Stefmci/ELEK_Inv_Pen/README.md

# 🔩 **PCB-Entwicklung – Chaos™**  

## 📁 Inhalt  

Hier findest du:  
- 🛠 Schaltpläne, die irgendwann funktionieren könnten  
- 📜 Geroutete Leiterbahnen mit fragwürdiger Eleganz  
- 🔥 Fehlerlisten, die mit jedem Testlauf länger werden  
- ⚡️ Magic Smoke™ – wenn wieder etwas *nicht ganz* geklappt hat  

## ⚠️ Warnung  

Dieses Repo enthält:  
- **Mysteröse Netzlisten**, die sich von selbst ändern  
- **Bauteile, die eigentlich kompatibel sein sollten** (aber nicht sind)  
- **Geroutete Antennen**, die sicher irgendwie gut sind  
- **Design-Rule-Warnings**, die ich absichtlich ignoriere  

💡 **Benutzung auf eigene Gefahr. Keine Garantie auf Funktion oder dass dein STM32 nach dem ersten Test noch lebt.**  

## 🧠 Motivation  

- 10% Ingenieurskunst  
- 30% Trial & Error  
- 60% „Warum drehen sich die Motoren nicht?“  

## 🚀 Roadmap  

- [ ] PCB entwerfen **ohne Kurzschlussfestival**  
- [ ] STM32 mittels **in vielleicht in Zukunft erstellter Firmware** ansteuern
- [ ] Mindestens **eine Platine löten**, ohne den Rauchmelder auszulösen   

## 📜 Lizenz  

Solange du meinen Schaltplan nicht benutzt, um einen Lötwettbewerb zu gewinnen:  
**Mach, was du willst! 😎**
