Stefmci/ELEK_Inv_Pen/Eckstein_Goetz_Hoertnagl.pdf

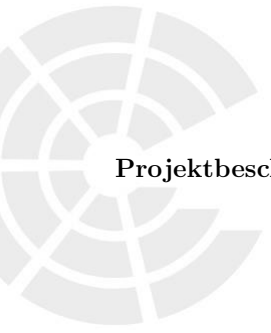
[picture p1: figure]

# Projektbeschreibung inverses Pendel

Bachelor: Mechatronik

### 4. Semester

Lehrveranstaltungsleiter: Matthias Gfall

Gruppe: BA-MECH-23

Verfasser: Stefan Hörtnagl, Lennart Götz, Maximilian Eckstein

### 30. Juni 2025

# Einleitung

Im Rahmen der Lehrveranstaltung ”

Elektronische Produktentwicklung 1” wurde mit der hardwareseitigen Entwicklung eines mobilen inversen Pendels begonnen. Das Ziel des Projekts besteht darin, einen zweirädrigen Roboter mit Dualantrieb zu entwickeln und zu bauen, der einen Pendelkörper in instabiler Gleichgewichtslage balanciert. [1]

Zentrales Thema dieses Semester war die Hardwarekonzeptionierung und -entwicklung. Ein Mikrocontroller erfasst die Sensordaten, verarbeitet sie und steuert entsprechend die Motoren, um das System zu stabilisieren.[1]

Basierend auf einer Literaturrecherche zur Regelung inverser Pendel wurde ein Grobkonzept erstellt, das die Auswahl geeigneter Komponenten (Sensoren, Aktoren und Mikrocontroller) sowie die Konstruktion, das Schaltungsdesign und die PCB-Entwicklung umfasst. Aufgrund der Komplexität des Themas sind mindestens zwei Hardware-Iterationen vorgesehen. Im ersten Teil der Lehrveranstaltung wurde zunächst die digitale Entwicklung umgesetzt.[1]

Nach Abschluss kann der entwickelte Aufbau als Demonstrator oder als Plattform fur Laborversuche ¨ im Bereich der Regelungstechnik eingesetzt werden.[1]

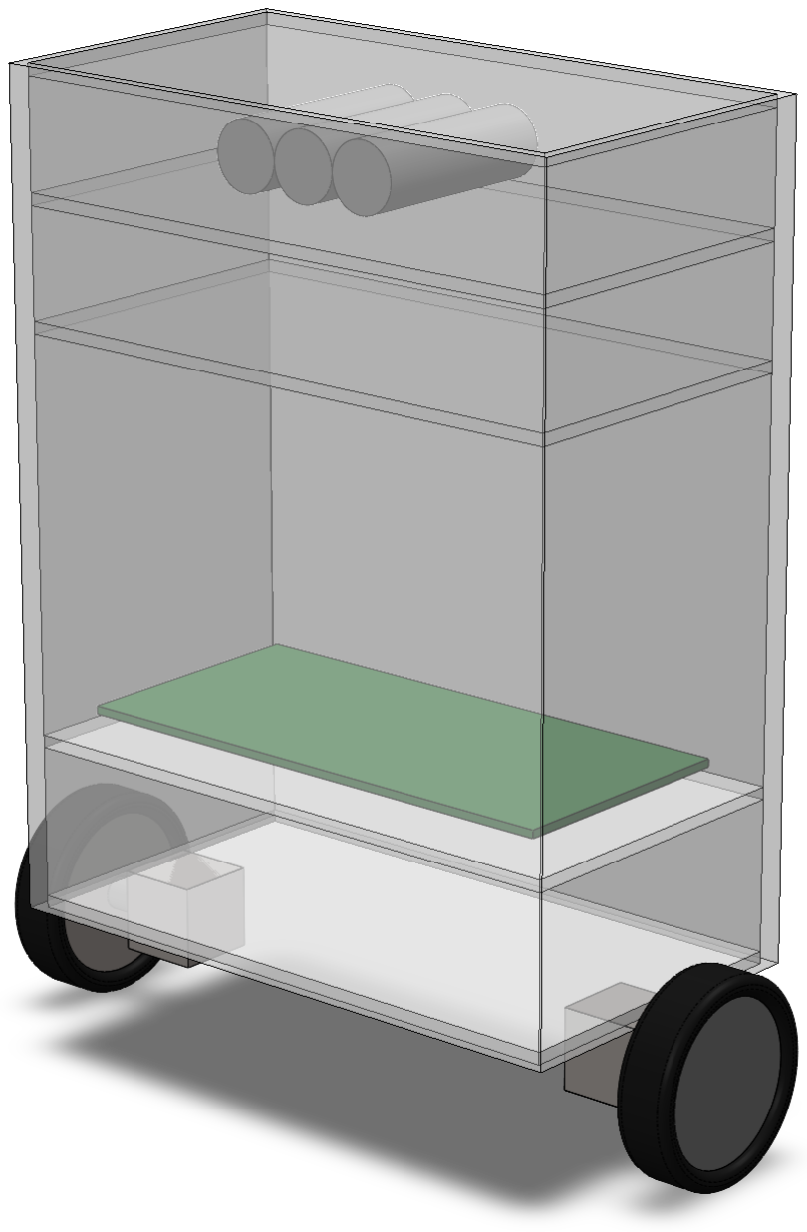
[picture p2: figure]

Abbildung 0.1: Entwurf inverses Pendel

II

# Inhaltsverzeichnis

1 Projektzusammenfassung | 1
2 Konzeptionierung | 1
3 Schaltungsentwicklung | 3
4 PCB Design | 20
4.7 Leiterplattendesign fur ein Standalone ESP8266EX-Modul | ¨ | 23

III

5 Mechanischer Aufbau | 26
6 Kostenkalkulation | 28
7 Pinbelegung und Funktionszuordnung | 29
Abbildungsverzeichnis | V
Tabellenverzeichnis | VI
Literaturverzeichnis | VII

IV

# 1 Projektzusammenfassung

Gegenstand des Projekts ist der Bau eines Fahrgestells fur den Einsatz in der Lehre. Das Gestell soll ¨ als inverses Pendel ausgefuhrt werden und sich – nach Implementierung eines geeigneten Regelalgo- ¨ rithmus – selbstständig in der oberen Ruhelage stabilisieren. Daraus ergeben sich die in Kapitel 2 beschriebenen Anforderungen. [1]

Obwohl das System in weiten Teilen digital konzipiert und in Form von Schaltplänen, PCB-Layouts und 3D-Modellen ausgearbeitet wurde, konnte aufgrund der hohen Komplexität und des begrenzten zeitlichen Rahmens bislang keine physische Umsetzung erfolgen. Die Realisierung des Prototyps ist
jedoch fur eine sp ¨ | ätere Projektphase vorgesehen.[1]

# 2 Konzeptionierung

### 2.1 ENERGIEVERSORGUNG

Um einen sicheren Betrieb, schnelle Ladezeiten und den geforderten einfachen Akkuwechsel zu ermöglichen, kommt ein Lithium-Ionen Akku von Makita zum Einsatz. Dieser bietet eine hohe Energiedichte und beinhaltet bereits ein Battery-Management System welches Tiefenentladungen verhindert.
Außerdem sind im Gestell zwei verschiedene Steckplätze fur den Akku vorgesehen. Dies erm ¨ | öglicht
eine Variation des Schwerpunkts des Gesamtsystems.

Da die Spannung des Akkus unter Belastung signifikant absinken kann, wird ein DC-DC Wandler zur Entkopplung verwendet. Dadurch bleibt die Spannung am Motortreiber auch unter Last stabil. Die Regelung der Motorleistung wird dadurch ebenfalls vereinfacht.

### 2.2 ANTRIEB

Motorauslegung:
Fur die Motorauswahl wurde zun ¨ | ächst ein maximaler Neigungswinkel definiert, bei dem das Pendel
noch stabilisiert werden soll. Mithilfe dieses Neigungswinkels wurde ein maximales Kippmoment berechnet, das als Auslegungskriterium fur das erforderliche Motordrehmoment herangezogen wurde. ¨

Zur Berechnung des Kippmoments in MATLAB wurde der mechanische Aufbau des Pendels einschließlich seiner Dimensionen definiert. Sämtliche Bauteile wurden virtuell innerhalb des Systems positioniert. Mithilfe des Schwerpunktsatzes konnte der Gesamtschwerpunkt des Pendels approximiert werden. In Kombination mit dem vorgegebenen Neigungswinkel wurde daraus das maximale Kippmoment inklusive Sicherheitsreserve ermittelt.

Von Seiten des MCI wurde empfohlen, einen Gleichstrommotor mit Getriebe zu verwenden. Nachdem das erforderliche Drehmoment sowie die Betriebsspannung (12V) festgelegt worden waren, konnte ein geeigneter Motor ausgewählt werden. Neben dem Drehmoment war dabei auch eine ausreichend hohe Drehzahl entscheidend, um schnelle Regelbewegungen zu ermöglichen und das Pendel zuverlässig in der oberen Ruhelage auszuregeln.

Motor Treiber:
Um das Drehmoment der gewählten Motoren uber den STM32 regeln zu k ¨ | önnen, wird eine geeignete
Leistungselektronik benötigt. Zum Einsatz kommt eine H-Brucke, die ein PWM-Signal zur Ansteue- ¨ rung der Motoren erzeugt. Durch Variation des Duty Cycles wird der Effektivwert der Motorspannung angepasst. Infolgedessen stellt sich ein mittlerer Motorstrom ein, der das resultierende Drehmoment bestimmt.

Es bestehen folgende Anforderungen an die H-Brucke: ¨ Betriebsspannung: 12V
maximale Strombelastung: 7A
optional: Unterstutzung von 2 Motoren ¨
optional: Unterstutzung von 3.3V Signalen des STM32 ¨

Anhand dieser Merkmale, wurde ein Dual-Channel Motor Treiber mit folgenden technischen Daten ausgewählt:

Betriebsspannung | 6.5V - 37V
Imax | 12A
Ipeak | 70A
Steuerspannung | 3V - 5V

Tabelle 2.1: Technische Daten

### 2.3 KOMMUNIKATIONSSCHNITTSTELLEN

Eine Kernanforderung an das System ist die Unterstutzung der MATLAB-Codegenerierung. Aus Si- ¨ mulink soll C-Code generiert werden, der anschließend uber eine USB-Schnittstelle auf den Controller ¨ ubertragen wird. ¨
Zusätzlich sollen Telemetriedaten während des Betriebs drahtlos ubertragen werden k ¨ | önnen. Dazu
wurde ein ESP8266 Chip integriert, der Daten vom Controller empfängt und uber WiFi versenden ¨ kann. Der ESP8266 soll - ebenso wie der Mikrocontroller - uber USB (via UART) programmierbar ¨ sein.
Da der ESP8266 nur uber eine einzige UART-Schnittstelle verf ¨ | ugt, wurde ein dualer Signal-Multiplexer ¨
eingesetzt, um sowohl die Programmierung als auch die Kommunikation mit dem STM32 zu ermöglichen.

Aus diesen Anforderungen entwickelten wir folgende Topologie fur die UART-Kommunikation: ¨

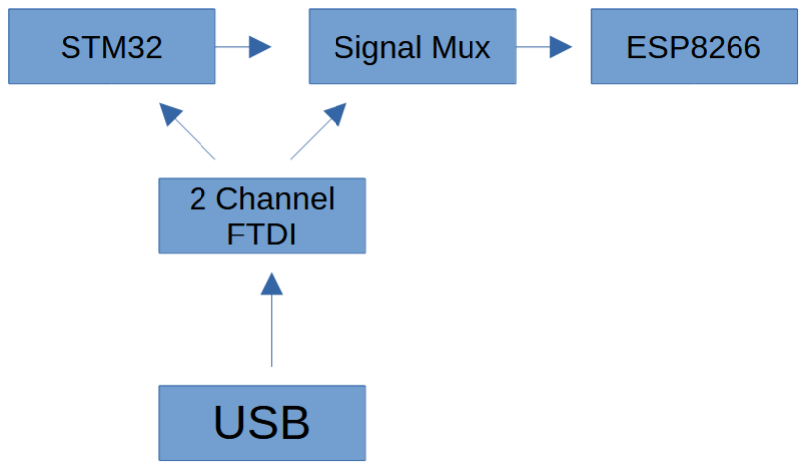
[picture p3: figure]

Abbildung 2.1: UART Topologie

### 2.4 SENSORIK

Um den Pendelkörper in der oberen Ruhelage ausregeln zu können, muss dessen Neigung erfasst werden. Ergänzend liefert die Messung der Beschleunigung wertvolle Informationen uber die System- ¨ dynamik.
Zur Erfassung von Neigung und Beschleunigung wurde der Inertialsensor LSM6DSOX ausgewählt. Dieser kombiniert einen 3-Achsen-Beschleunigungssensor mit einem 3-Achsen-Gyroskop und ermöglicht so eine präzise Erfassung der Bewegungs- und Lageinformationen bei gleichzeitig geringem Energieverbrauch.

# 3 Schaltungsentwicklung

### 3.1 STM32 UND LAGESENSOR

Um die Regelung des inversen Pendels zu implementieren, wird ein Mikrokontroller verwendet. Da der Steuerungs-Code automatisch aus MATLAB generiert werden soll, wurde hier auf entsprechende Kompatibilität geachtet. Um ausreichend Rechenleistung fur zuk ¨ unftige Erweiterungen (z.B. LI- ¨ DAR) bereitzustellen, fiel die Wahl auf einen STM32H7A3. Zur Reduzierung der Komplexität wurde ein Gehäuse mit 64 Pins verwendet, um ein möglichst minimalistisches Leiterplattenlayout zu ermöglichen.

Um den stabilen Betrieb des STM32 zu ermöglichen, haben wir uns am Design-Guide von STMicroelectronics speziell fur diese Chipserie orientiert. An geeigneter Stelle wurden Keramikkondensatoren ¨ platziert um die Spannungsversorgung zu stabilisieren. Außerdem wird einen externer Quarz mit 24Mhz verwendet, da das resultierende Clocksignal damit frequenzstabiler ist.

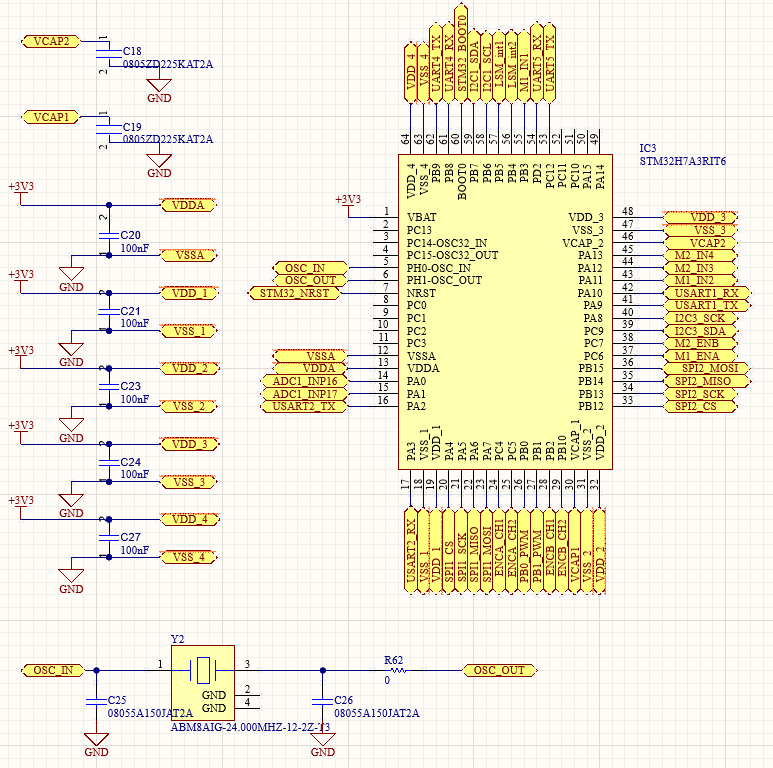
[picture p4: figure]

Abbildung 3.1: STM32 mit Quarz und Kondensatoren

Zur Erfassung der Neigung des Pendels sowie gegebenenfalls der Beschleunigung wurde ein geeigneter Sensor integriert. Die ursprunglich in Betracht gezogene und weit verbreitete MPU9250 wurde ¨ verworfen, da der Hersteller die Produktion eingestellt hat. Stattdessen kommt ein LSM6DSOX von STMicroelectronics zum Einsatz. Dieser Chip umfasst ein 3-Achsen-Gyroskop sowie Beschleunigungs-
messung in 3 Achsen. Die Sensordaten werden uber eine SPI Verbindung an den STM32 ¨ | ubermittelt. ¨
Da die Schnittstelle bidirectional ist, kann der Sensor auch uber den STM32 konfiguriert werden. ¨ Beim Schaltungsdesign wurde sich erneut an der Dokumentation von STMicroelectronics orientiert. Zur Glättung der Versorgungsspannung wurden Keramikkondensatoren in unmittelbarer Nähe zum Sensor platziert.

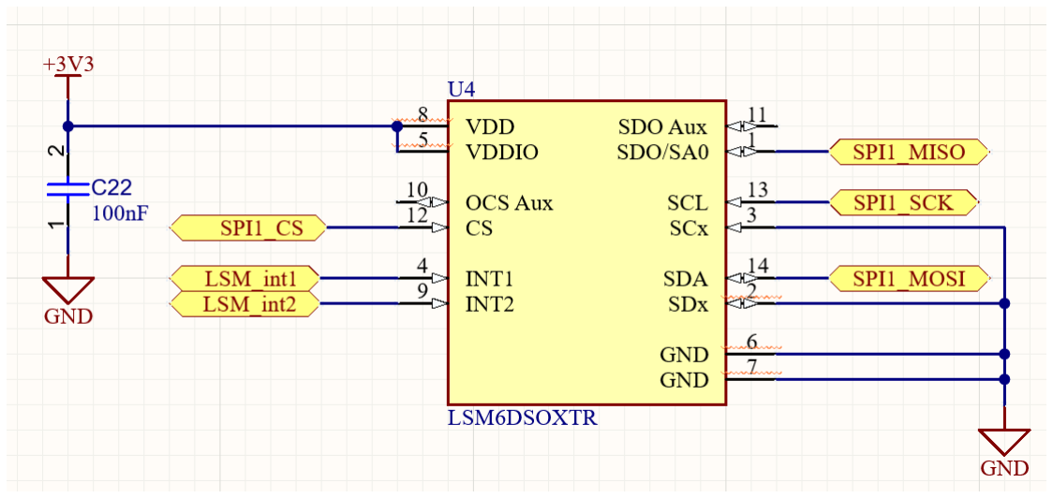
[picture p5: figure]

Abbildung 3.2: LSM6DSOX

### 3.2 UART KOMMUNIKATION

Basierend auf unserer UART-Topologie wurde die Umsetzung der UART-Kommunikation in drei Teile gegliedert: FTDI-Chip (USB-UART), UART-Signalumschaltung und Bootloader Aktivierung

FTDI-Chip:

Mithilfe des FTDI-Chips können sowohl der STM32 als auch der ESP8266 programmiert werden. Der
Chip verfugt ¨ | uber zwei unabh ¨ | ängige UART-Kanäle, die vom Computer jeweils als separate virtuelle
COM-Ports erkannt und genutzt werden können. Dadurch ist es gezielt möglich, den gewunschten ¨
Controller fur die Programmierung auszuw ¨ | | ählen.
Prinzipiell fungiert der FTDI-Chip als Signalumsetzer: Er wandelt das eingangsseitige USB-Signal vom PC in ein TTL/UART-Signal um, das von den Controllern verarbeitet werden kann.
Bei der Ausarbeitung der Beschaltung des FTDI-Chips wurde neben dem Design Guide des Herstellers auch ein bestehendes Breakout-Modul von FTDI herangezogen, das auf demselben Chip basiert. Der EEPROM-Speicher ist nicht essenziell fur den Betrieb, kann jedoch zur Ablage hilfreicher Infor- ¨ mationen genutzt werden – beispielsweise eines benutzerdefinierten Gerätenamens oder der Konfiguration des COM-Ports. Dies erleichtert die Handhabung und Integration des Projekts insbesondere bei mehrfacher Verwendung an verschiedenen Computern.
Der FTDI ist so beschaltet, dass er nur aktiv wird, sobald ein Gerät am USB-C-Port angeschlossen ist.
Daruber hinaus verf ¨ | ugt der FTDI ¨ | uber einen externen Schwingkreis, um ein stabiles Taktsignal be- ¨
reitzustellen, das fur eine zuverl ¨ | ässige USB-Kommunikation gemäß Spezifikation erforderlich ist.
Kondensatoren und Ferritperlen dienen der Entkopplung sowie der Filterung hochfrequenter Störungen und verbessern dadurch die Signalqualität sowie die EMV-Eigenschaften der Schaltung.
Außerdem wurden vier Status-LEDs zur Anzeige der RX- und TX-Aktivität von Kanal 1 und 2 implementiert.

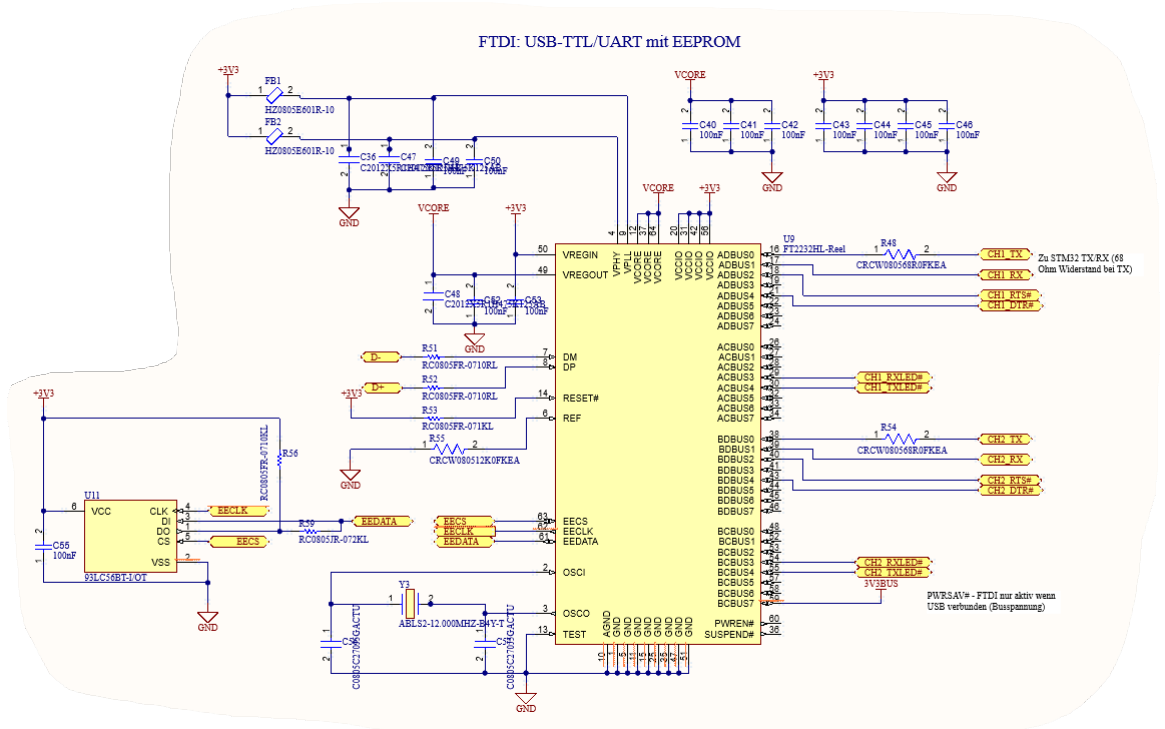
[picture p6: figure]

Abbildung 3.3: FTDI-Chip mit Peripherie

UART-Signalumschaltung:

Zur flexiblen Umschaltung der UART-Verbindung des ESP8266 zwischen STM32 und FTDI wurde ein analoger Multiplexer (TS5A23157) implementiert. Dieser ermöglicht, abhängig von den Steuerleitungen IN1 und IN2, die gezielte Verbindung der TX- und RX-Leitungen entweder zum Mikrocontroller (STM32) oder zum USB-UART-Konverter (FTDI CH2). Die Steuerung kann automatisch uber die ¨ invertierte RTS-Leitung des FTDI erfolgen oder manuell per Schalter.
Schalter 1 legt fest, ob die Umschaltung automatisch (uber die RTS-Leitung des FTDI) oder manu- ¨ ell erfolgt. Schalter 2 bestimmt – im manuellen Modus – welcher UART-Kanal mit dem ESP8266 verbunden wird.
Da der ESP8266 im Normalfall nur selten programmiert werden muss, ist die Standardverbindung uber die NC-Kontakte (Normally Closed) mit dem STM32 vorgesehen. ¨
Da jeweils einer der beiden UART-Pfade (STM32–ESP oder FTDI–ESP) inaktiv ist, wurden beide RX-Leitungen mit Pull-Up-Widerständen auf High gezogen, um unerwunschtes Floating zu vermei- ¨ den. Zusätzlich sind die UART-Leitungen zum ESP8266 mit 68-Ohm-Widerständen abgesichert, um Pegelkonflikte bei gleichzeitigem Anschluss zu vermeiden.
Fur den Fall, dass die Programmierung des ESP8266 ¨ | uber die eigens entwickelte USB-UART- ¨
Schaltung nicht funktioniert, ermöglichen Jumper-Verbindungen den Anschluss eines externen Programmieradapters.

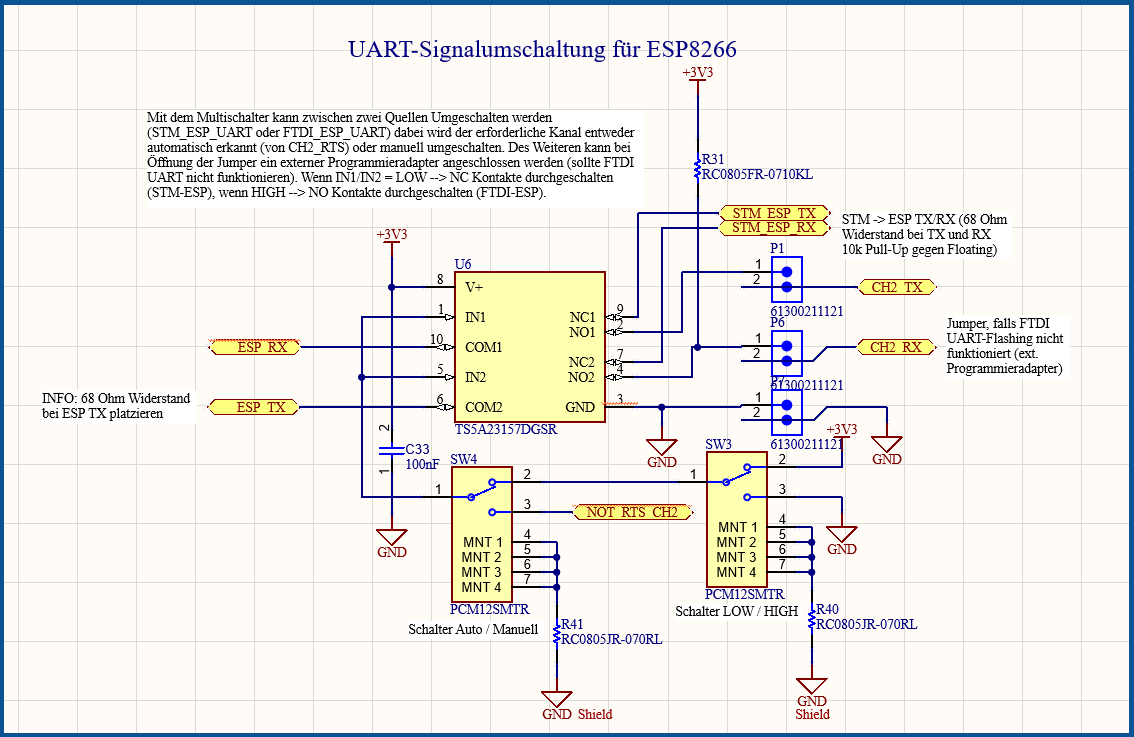
[picture p7: figure]

Abbildung 3.4: UART-Signalumschaltung

Bootloader Aktivierung:

Zur Aktivierung des Bootloaders fur STM32 und ESP8266 wurde eine Schaltung entwickelt, die ¨
sowohl automatisch uber die RTS- und DTR-Leitungen des FTDI-Chips als auch manuell ¨ | uber Taster ¨
ausgelöst werden kann. Die Signale RTS und DTR sind als active-LOW ausgefuhrt und werden ¨ | uber ¨
einen Inverterbaustein (SN74LVC14AD) sowie nachgeschaltete Open-Drain-MOSFETs entkoppelt,
um Kurzschlusse beim gleichzeitigen manuellen Bet ¨ | ätigen der Taster zu vermeiden und die FTDI-
Ausgänge zu schutzen. ¨

Da die Transistorschaltungen invertierend wirken, wird durch die zusätzliche Invertierung im IC das ursprungliche logische Verhalten wiederhergestellt. Die Umschaltung erfolgt entweder automatisch ¨
uber Softwaresteuerung durch den FTDI oder alternativ durch manuelle Bet ¨ | ätigung der vier Taster.

Fur den STM32 wird der Bootloader aktiviert, indem BOOT0 auf High und anschließend der Reset- ¨ Pin (NRST) kurzzeitig auf Low gezogen wird. Beim ESP8266 erfolgt die Aktivierung durch ein kurzes Herunterziehen des EN-Pins (Reset) bei gleichzeitigem Low-Pegel auf GPIO0. Beide Controller star-
ten so im Flashmodus und können uber die jeweilige UART-Schnittstelle programmiert werden. ¨ | Uber ¨
Jumper lassen sich die FTDI-Signale gezielt trennen, um beispielsweise einen externen Programmieradapter zu verwenden oder die automatische Umschaltung zu deaktivieren.

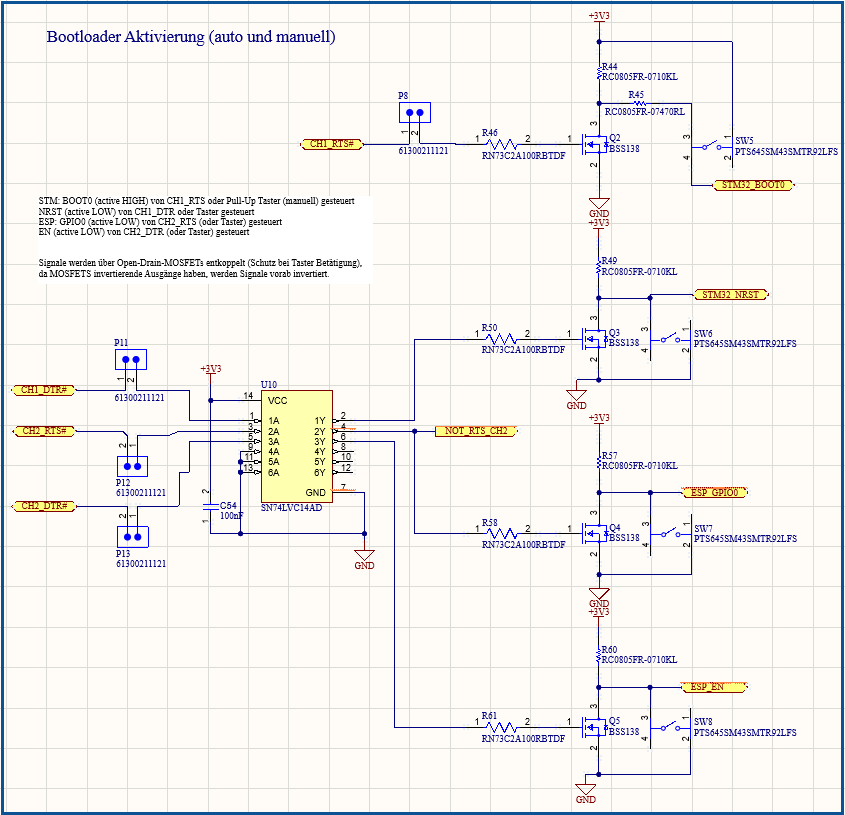
[picture p8: figure]

Abbildung 3.5: Bootloader-Schaltung

### 3.3 WIFI-SCHNITTSTELLE

Fur die drahtlose Kommunikation des Mikrocontrollers wurde der ESP8266EX[2] WiFi-Chip gew ¨ | ählt.
Er erfullt alle Projektanforderungen und besitzt eine kompakte Bauweise. Aufgrund seiner weiten ¨ Verbreitung in vielen Anwendungen ist er eine solide Basis. Der ESP8266EX bietet dabei eine Vielzahl von Funktionen:
- IEEE 802.11 b/g/n-Standard
- 32-Bit RISC-Prozessor mit bis zu 160 MHz Taktfrequenz
- diverse digitale Schnittstellen wie GPIO, SPI, I²C, UART und PWM.

Er kann im Deep-Sleep-Modus mit 20 µA im Ruhemodus gehalten werden und eignet sich dadurch besonders fur batteriebetriebene und energieeffiziente IoT-Anwendungen. ¨

Ein entscheidender Vorteil ist die Unterstutzung durch eine große Community sowie die umfangreiche ¨ Dokumentation und Softwareentwicklungsumgebung (SDK), die eine schnelle und flexible Softwareentwicklung ermöglicht. Die WLAN-Kommunikation wird hauptsächlich dazu verwendet, Echtzeitdaten der Sensoren und des Systemzustands zu senden und auf einem entsprechenden Webserver Interface wiederzugeben. Aufgrund der selbst designten PCB-Antenne wurde eine vollumfängliche Backup-Lösung vorgesehen.

### 3.3.1 Allgemeine Spezifikationen

- Prozessor: Tensilica L106, 32-bit RISC, bis 160 MHz
- Speicher: Externe SPI-Flash bis 16 MB, < 50 kB SRAM nutzbar
- Wi-Fi: 802.11 b/g/n (2.4 GHz)
- Datenrate: Bis 72.2 Mbps (802.11n)
- Schnittstellen: GPIO, UART, SPI, I2C, I2S, PWM, ADC , IR
- Betriebsspannung: 2.5 V – 3.6 V
- Stromverbrauch:

– Aktiv: ca. 80 mA
– Light-Sleep: 0.9 mA

– Deep-Sleep: 20 µA

Die herstellerspezifischen Hardware-Design-Rules wurden bei der Entwicklung des Schaltplans und des PCB-Designs berucksichtigt und eingehalten. ¨

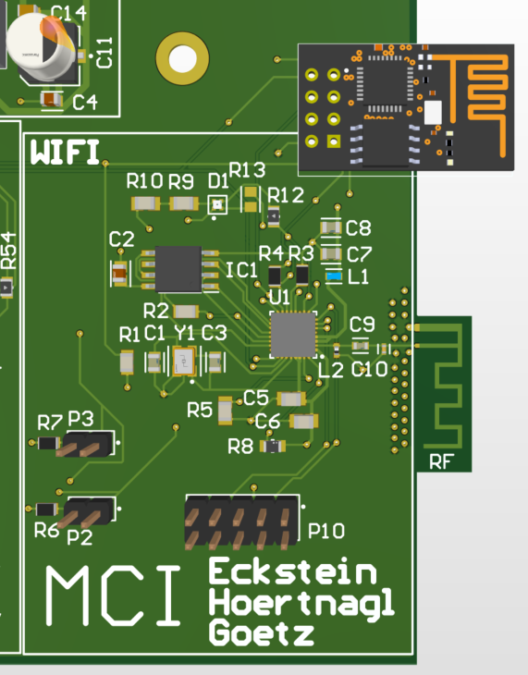
[picture p9: figure]

Abbildung 3.6: PCB Abschnitt WiFi

### 3.4 SCHALTUNGSDETAILS DES WIFI-MODULS (ESP8266)

Die Peripherie wurde hierbei in die folgenden Sektionen am Schaltplan unterteilt:

- Spannungsversorgung
- Antenne und Stromversorung Antenne
- Flash
- Oszillator
- Backup Modul
- Kleinteile

### 3.4.1 Stromversorgung

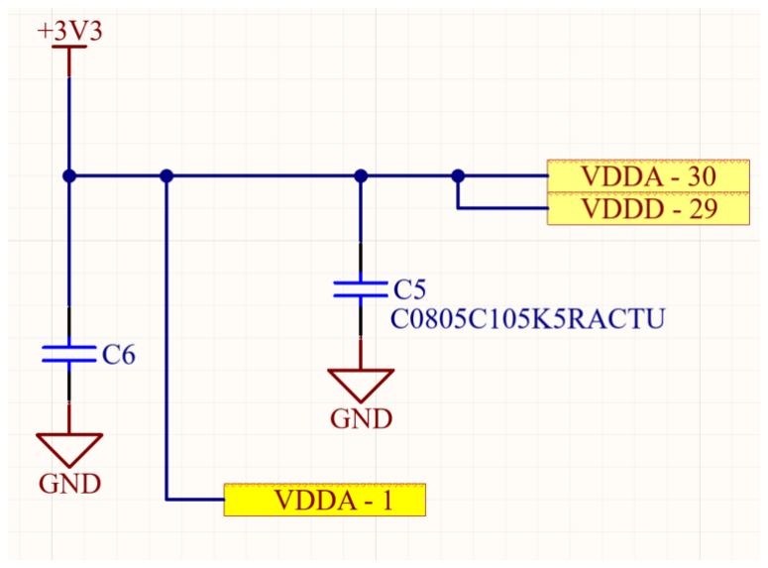
[picture p10: figure]

Abbildung 3.7: Stromversorgung ESP8266

Die Stromversorgung wurde gemäß den Design-Richtlinien[3] umgesetzt. Dazu gehören zwei 1µF-Kondensatoren, die zur Filterung hochfrequenter Störungen beitragen. Die Versorgung uber VDDA30, ¨ 29 und 1 dient der Spannungsbereitstellung fur die analogen Komponenten des ESP, die besonders ¨
empfindlich gegenuber Spannungsschwankungen sind. Daruch wird eine st ¨ | örungsfreie Verwendung
garantiert, ohne dass das Risiko von Paketverlusten oder unerwarteten Resets besteht.

### 3.4.2 Stromversorgung Antenne

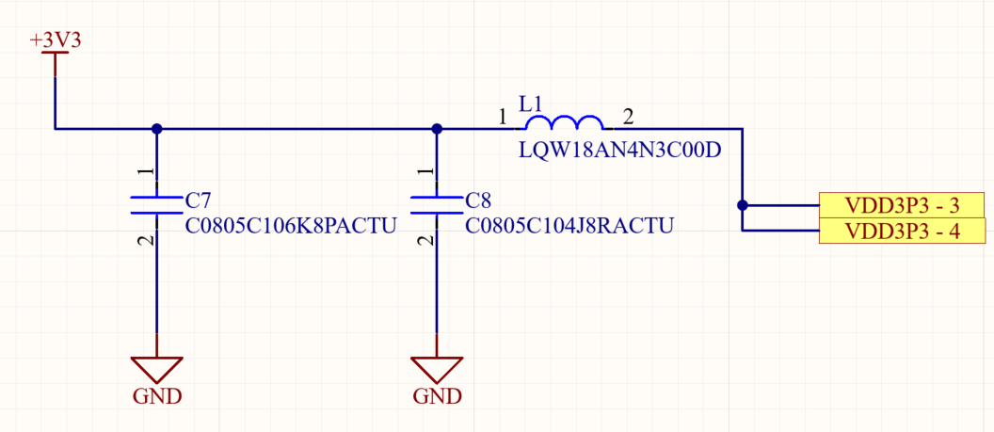
[picture p11: figure]

Abbildung 3.8: Stromversorgung Antenne

Diese Schaltung ist mit dem internen Power-Amplifier und dem Low-Noise-Amplifier verbunden und
sorgt fur die Versorgung des Antennenbereichs des Chips. Dabei fungiert der ¨ | 10µF Kondensator (C7)
als Energiespeicher, da während des Sendens ein hoher Stromverbrauch entstehen kann. Der Kondensator C8 dient zur Filterung von hochfrequenten Ruckkopplungen. Die Schaltung wurde nahe den ver- ¨ wendeten Pins im PCB-Layout vorgesehen. Dadurch werden typische Probleme wie Ruckkopplungen, ¨ Rauschen im RF-Signal oder Störungen im Betrieb vermieden.

### 3.4.3 Antenne

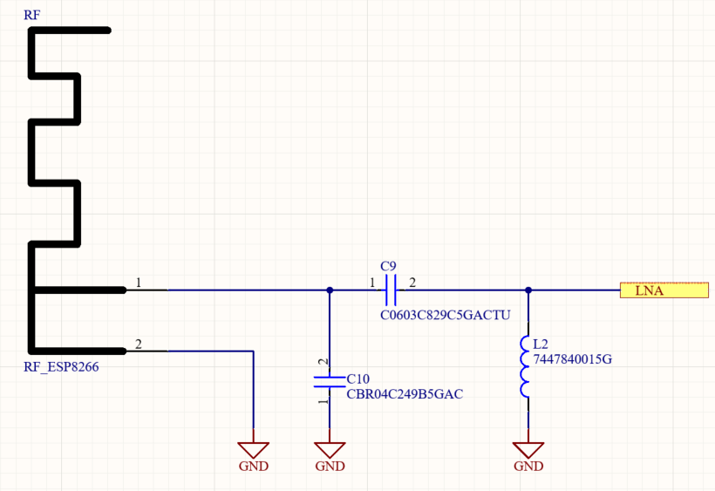
[picture p12: figure]

Abbildung 3.9: Antenne

Der RF-Ausgang des ESP8266EX hat eine charakteristische Impedanz von 39 + j6 Ω. Um eine ver-
lustarme Leistungsubertragung zur Antenne sicherzustellen, ist eine Anpassung an ¨ | 50 Ω notwendig.

Zur Impedanzanpassung des RF-Ausgangs an die 50 Ω Antenne wurde ein π-Matching-Netzwerk ausgelegt. Ziel war es, die komplexe Ausgangsimpedanz des LNA-Pins (Zs = 39 + j6 Ω) auf die Antennenimpedanz von ZL = 50 Ω abzustimmen. Als Betriebsfrequenz wurde 2.45 GHz gewählt (Mittenfrequenz im 2.4 GHz-WLAN-Band).

Fur das Matching wurde folgende Bauteilkombination verwendet: ¨

- C9 = 8,2 pF
- L2 = 1,5 nH
- C10 = 2,4 pF

Die Impedanzanpassung erfolgte mithilfe eines Matching-Rechners. Als Antenne wurde eine direkt im PCB integrierte Variante umgesetzt, die uber definierte Leiterbahnstrukturen realisiert ist. Die ¨ Antennenfläche wurde gemäß den offiziellen Hardware Design Guidelines von Espressif konsequent von metallisierten Flächen und Signalleitungen freigehalten und durch GND-Vias abgeschirmt [3]. Dadurch wird eine hohe Sendeleistung sowie eine gute Empfangsempfindlichkeit im 2.4 GHz-Band sichergestellt.

### 3.4.4 Flash

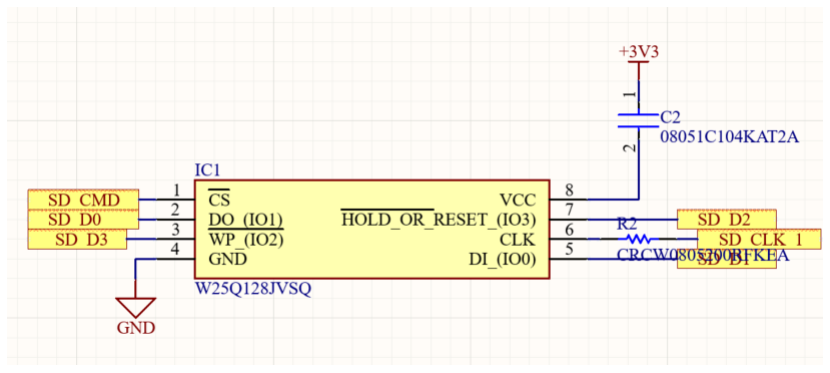
[picture p13: figure]

Abbildung 3.10: Flash Beschaltung ESP8266

Der ESP besitzt keinen internen Flash-Speicher, weshalb ein externer Flash-Speicher vorgesehen wurde. Die Kommunikation zwischen ESP und Flash erfolgt hierbei uber die SPI-Schnittstelle. C2 (100nF) ¨ ist ein Bypass-Kondensator, wie in den Guidelines[3] empfohlen, um Spannungsschwankungen zu dämpfen. R2 (200Ω) in Serie mit der Taktleitung (CLK): Dies reduziert die Treiberstromspitzen und verhindert EMV-Probleme. Es ist darauf zu achten den Flash im richtigen Modus zu konfigurieren, damit die Firmware korrekt gelesen werden kann.

Der gewählte Flash bietet hierbei folgende Spezifikationen[4]:

- 128 MBit = 16 MB Speicher
- Standard, Dual und Quad SPI
- 2.7 - 3.6 V Betriebsspannung

### 3.4.5 Oszillator

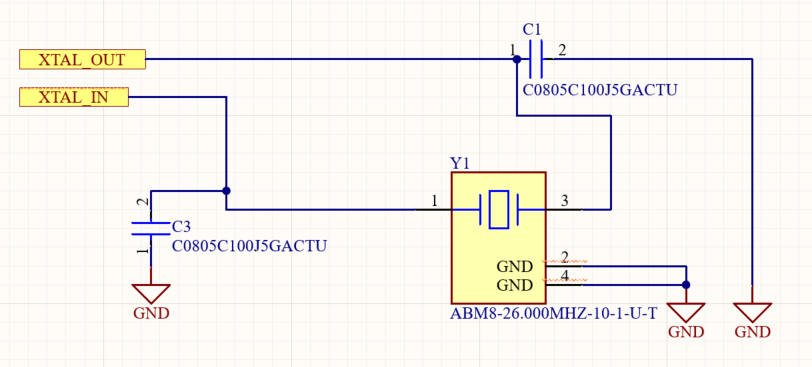
[picture p14: figure]

Abbildung 3.11: ESP Oszillator

Der ESP wird mit einer Frequenz von 26 MHz betrieben. Die Taktquelle hierfur ist der Oszillator[5]. ¨ Dieser ist notwendig, um die interne PLL des Chips zu takten und somit die Betriebsfrequenz des Prozessors und der WLAN-Funktionalität sicherzustellen. Bei der Verwendung des ESP Flash Download Tools muss die gewählte Frequenz korrekt eingestellt werden.

Der ESP8266EX unterstutzt Kristallfrequenzen von 24 MHz, 26 MHz oder 40 MHz. Die Frequenzge- ¨
nauigkeit des Quarzes liegt bei ±10 ppm, was den Anforderungen fur zuverl ¨ | ässige WLAN-Kommunikation
entspricht.

Der Quarz ist mit den Pins XTAL IN und XTAL OUT des Controllers verbunden. Fur eine korrekte ¨ Funktion werden zwei Kondensatoren (C1 und C3 mit 10 pF) gegen Masse geschaltet, die den Eingang und Ausgang des Oszillators stabilisieren.

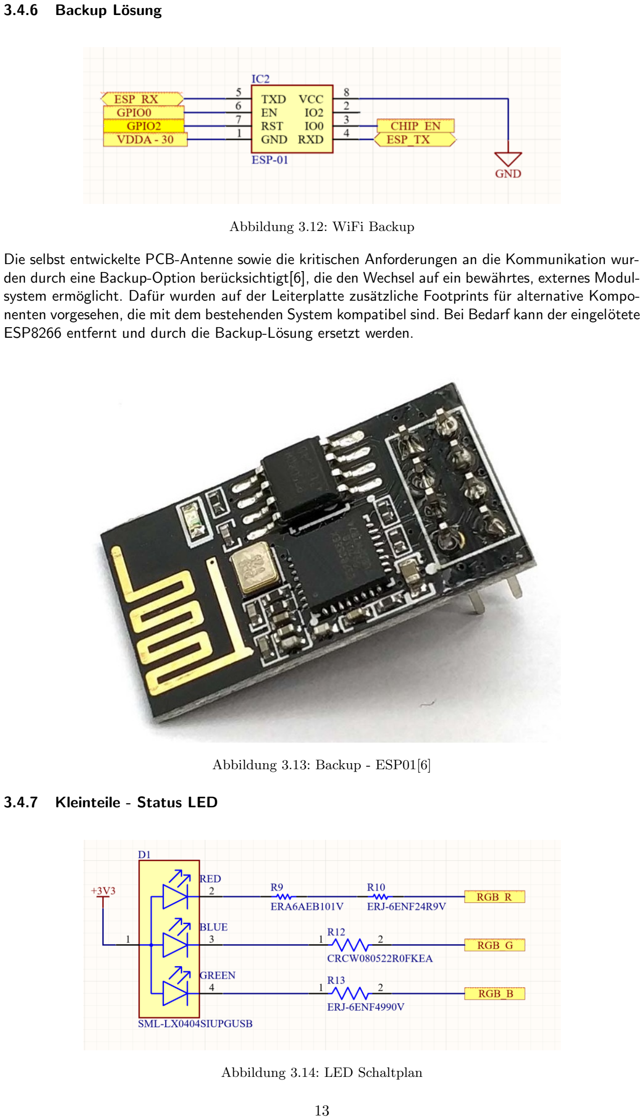
[picture p15: page 17]

### 3.4.6 Backup Lösung

Abbildung 3.12: WiFi Backup

Die selbst entwickelte PCB-Antenne sowie die kritischen Anforderungen an die Kommunikation wur-
den durch eine Backup-Option berucksichtigt[6], die den Wechsel auf ein bew ¨ | ährtes, externes Modul-
system ermöglicht. Dafur wurden auf der Leiterplatte zus ¨ | ätzliche Footprints fur alternative Kompo- ¨
nenten vorgesehen, die mit dem bestehenden System kompatibel sind. Bei Bedarf kann der eingelötete ESP8266 entfernt und durch die Backup-Lösung ersetzt werden.

Abbildung 3.13: Backup - ESP01[6]

### 3.4.7 Kleinteile - Status LED

Abbildung 3.14: LED Schaltplan

Zur Visualisierung des aktuellen Systemzustands wurde eine mehrfarbige Status-LED integriert. Diese
wird uber frei verf ¨ | ugbare, PWM-f ¨ | ähige GPIOs des ESP8266 angesteuert und ermöglicht die software-
seitige Erzeugung beliebiger Farben durch additive Farbmischung. Beispielsweise könnte bei Fehlfunktionen ein rotes Licht, beim Senden von Daten ein blaues Signal angezeigt werden. Die zugehörigen Vorwiderstände wurden wie folgt berechnet:

R =

VVersorgung − VLED

ILED

Dabei ist:

- VVersorgung: Betriebsspannung (z. B. 3,3 V)
- VLED: Vorwart-Voltage der LED
- ILED: gewunschter Strom ( ¨ | 10 mA)

Dabei spiegeln die Werte der Tabelle das Datenblatt der LED wider.

LED-Farbe | | VLED | ILED
Rot | | 195 V bis 2,15 V | 10 mA
Grun | 2 ¨ | ,75 V bis 2,95 V | 10 mA
Blau/Weiß | | 2,7 V bis 2,85 V | 10 mA

Berechnung der Widerstände:

Rrot =

3.3 V − 2.05 V
0.01 A

= 125 Ω

Rgrun¨ =

3.3 V − 2.85 V
0.01 A

= 45 Ω

Rblau/weiß =

3.3 V − 2.8 V
0.01 A

= 50 Ω

### 3.4.8 Kleinteile Allgemein

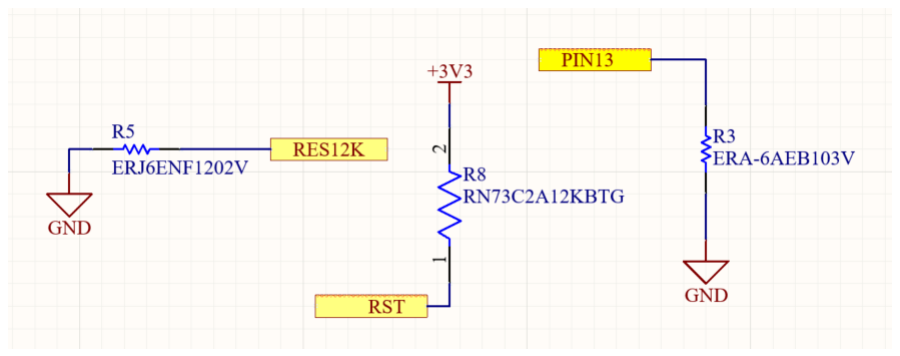
[picture p16: figure]

Abbildung 3.15: Pegel wichtiger Pins ESP8266

Der Widerstand R5 wurde zur internen Stromquellenkalibrierung in Verbindung mit dem RES12K-Pin auf Ground geschaltet. Er gehört zum Standarddesign des ESP8266 und ist fur einen stabilen Betrieb ¨ Pflicht.

Der RST-Pin ist ein Active-Low-Pin und muss fur den Betrieb auf High geschaltet werden. Dies ist ¨ mit einem 12kΩ Pull-Up-Widerstand realisiert.

Zusätzlich ist ein 10kΩ Pull-Down-Widerstand (R3) an einem Strapping-Pin vorgesehen. Dieser stellt
sicher, dass der ESP8266 im Flash-Boot-Modus startet. Das ist fur das Programmieren ¨ | uber UART ¨
erforderlich. Somit weiß der ESP, was er beim Start machen soll.

### 3.4.9 Breakout

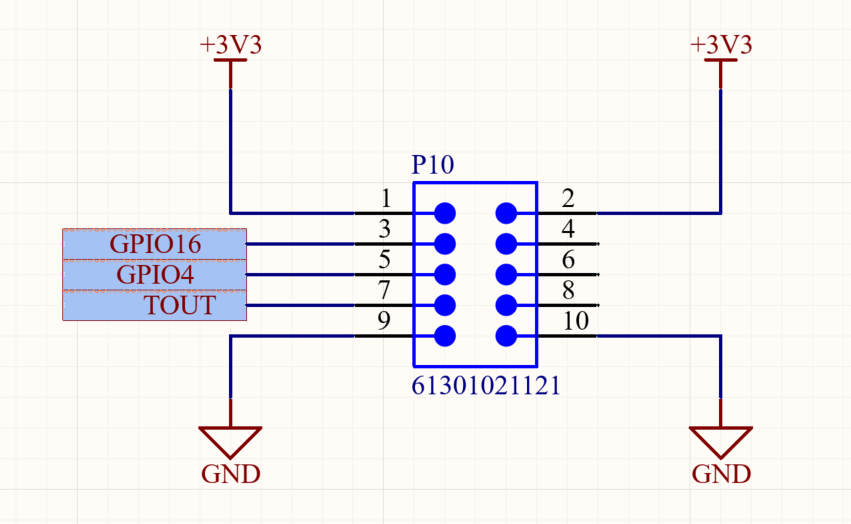
[picture p17: figure]

Abbildung 3.16: Breakout Pins ESP8266

Uber die herausgef ¨ | uhrten TOUT-Pins kann die Spannungsversorgung f ¨ | ur die Inbetriebnahme oder f ¨ | ur ¨
spätere Anwendungen uberwacht werden. GPIO 4 und 16 wurden ebenso f ¨ | ur die M ¨ | öglichkeit einer
späteren Anbindung uber die Pinleiste herausgef ¨ | uhrt. ¨

### 3.5 SPANNUNGSVERSORGUNG

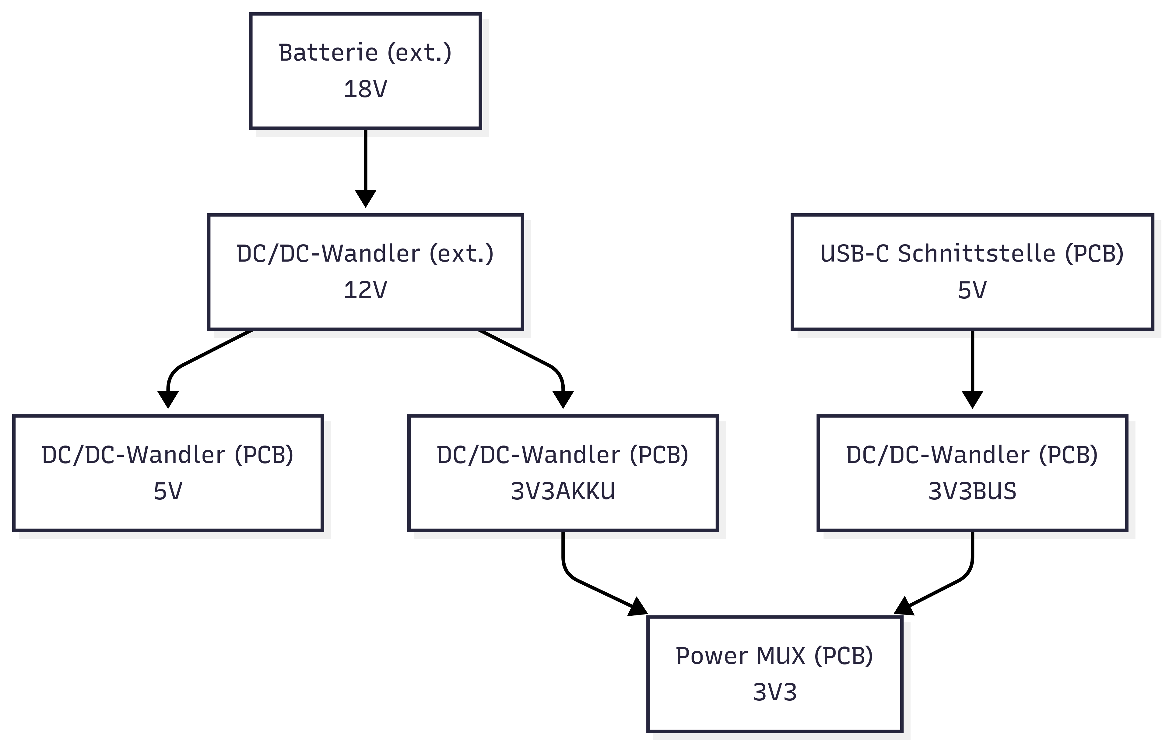
[picture p18: figure]

Abbildung 3.17: Energieversorgungsschema

Die Energieversorgung des Systems basiert auf zwei unabhängigen Eingangsquellen: einer externen 18V-Batterie sowie der USB-C-Schnittstelle mit 5V. Die Batteriespannung wird extern auf 12V reduziert und auf der Leiterplatte mittels DC/DC-Wandlern in die benötigten Spannungen 5V und 3.3V (3V3AKKU) gewandelt. Parallel dazu wird die USB-Spannung uber einen weiteren Wandler auf 3.3V ¨ (3V3BUS) transformiert. Die Stromversorgung ist somit sowohl im mobilen Akkubetrieb als auch im stationären USB-Betrieb möglich.

Der USB-Versorgungszweig dient primär Debugging- und Entwicklungszwecken. Die Platine kann vollständig betrieben und programmiert werden, ohne dass eine Batterie angeschlossen ist. Dies erleichtert Firmware-Updates, Tests und Fehlersuche erheblich, insbesondere im stationären Laborbetrieb.

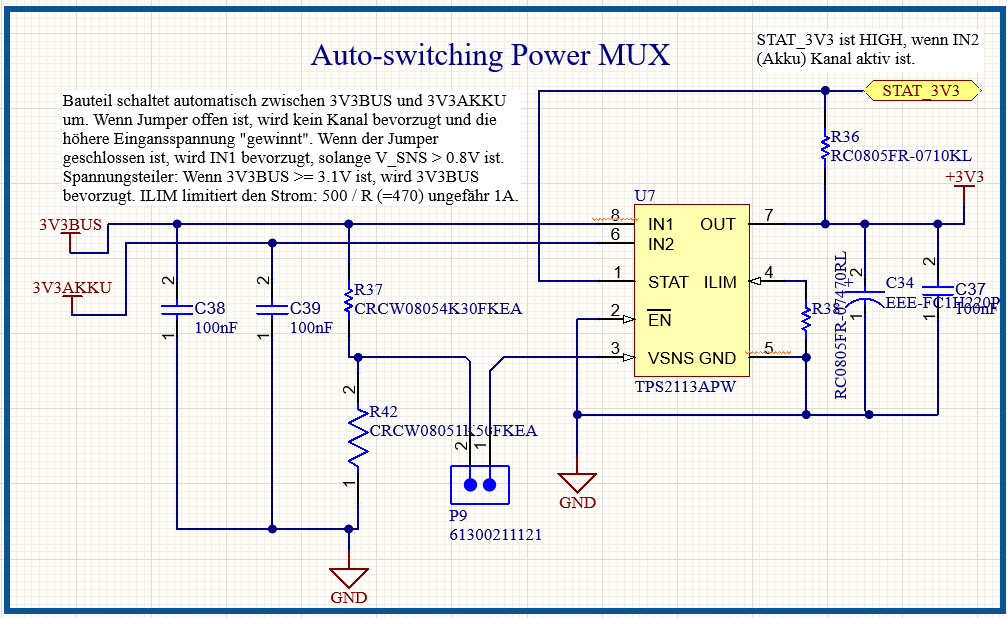
[picture p19: figure]

Abbildung 3.18: automatische Spannungsumschaltung

Ein zentraler Bestandteil ist der Power-Multiplexer (TPS2113A), der automatisch zwischen den beiden 3.3V-Zweigen umschaltet. Dabei kann entweder die Quelle mit höherer Spannung priorisiert werden, oder – sofern der Jumper gesetzt ist – der USB-Zweig (IN1) bevorzugt werden. Die Aus-
wahl erfolgt intern uber einen Spannungsteiler (VSNS), der bei einer USB-Spannung ¨ | ≥ 3.1V die
Umschaltung steuert. Uber einen externen Widerstand (R38 - 470 ¨ | Ω) lässt sich zudem der maximale
Ausgangsstrom auf ca. 1A begrenzen. Am Ausgang sorgen Elkos und Keramik-Kondensatoren fur die ¨ notwendige Stabilität der Versorgungsspannung.

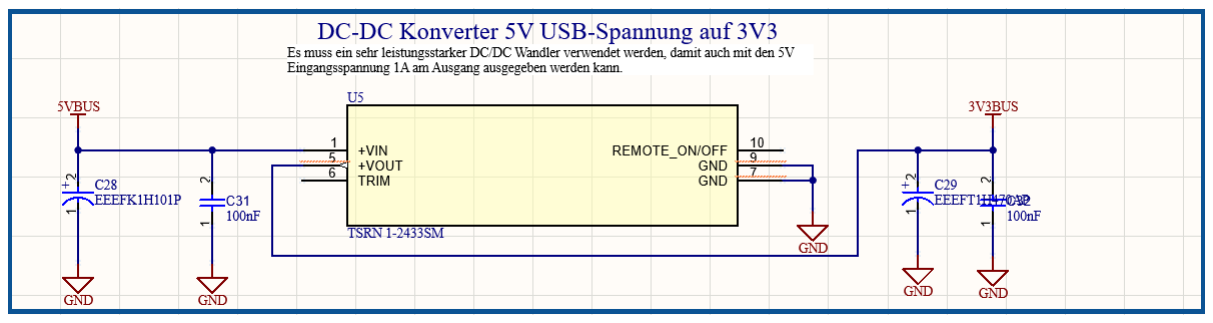
[picture p20: figure]

Abbildung 3.19: USB Spannungsversorgung

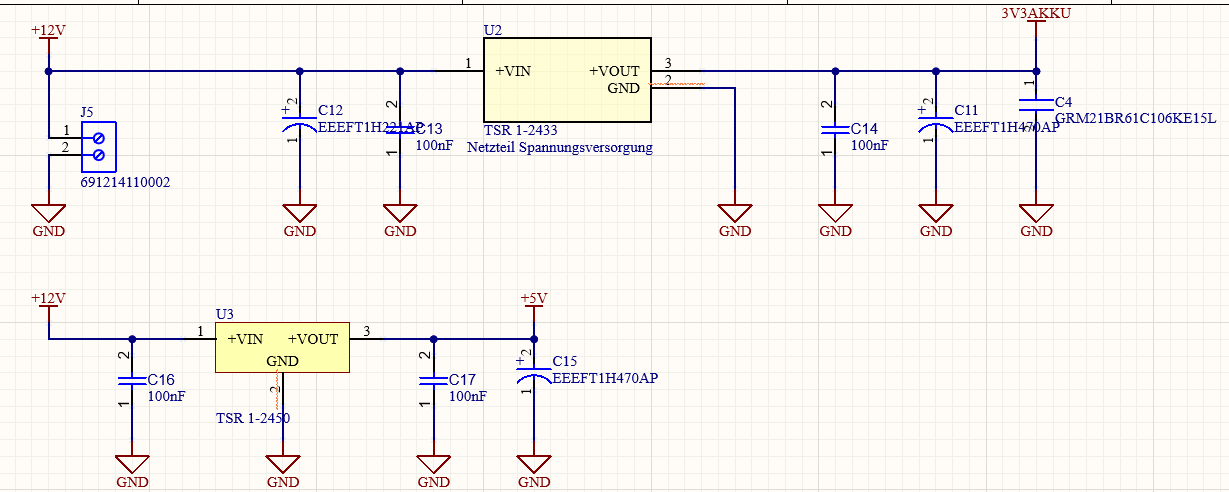
[picture p21: figure]

Abbildung 3.20: Spannungsversorgung durch Batterie

Fur alle Spannungswandlungen kommen hocheffiziente DC/DC-Wandler der TSR-Serie zum Einsatz. ¨ Neben dem Wandler fur die 3V3BUS-Spannung wird auch die Akkuspannung (12V) auf 5V und 3.3V ¨ gewandelt. Insbesondere fur den 3.3V-Kreis ist eine ausreichende Stromreserve erforderlich, da der ¨ WLAN-Chip (ESP8266) hohe Spitzenströme zieht. Ein linearer Spannungsregler wäre hier ineffizient gewesen und hätte unnötig Wärme erzeugt. Alle Wandler sind ein- und ausgangsseitig mit Elektrolytund Keramikkondensatoren gepuffert – Elkos liefern hohe Kapazität zur Energiespeicherung, KerKos reagieren schnell auf Lastwechsel und filtern hochfrequente Störungen.

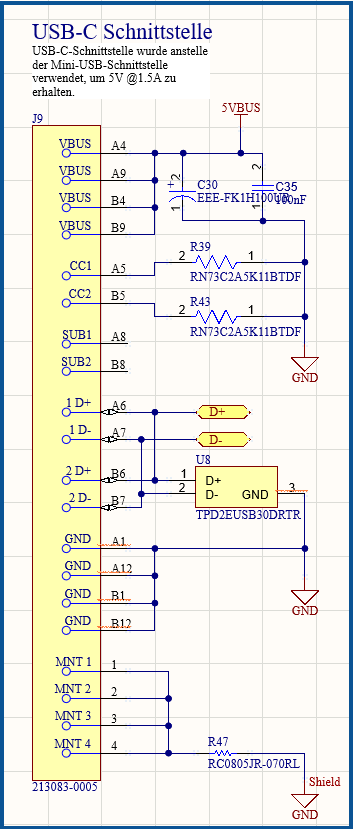
[picture p22: figure]

Abbildung 3.21: USB-C Schnittstelle

Die USB-C-Schnittstelle wurde anstelle eines Micro-USB-Anschlusses gewählt, da uber sie sicher 5V ¨ bei bis zu 1.5A bezogen werden können. Die korrekte Stromstärkevereinbarung erfolgt uber passende ¨ Pull-Down-Widerstände (5.11kΩ) an den CC-Pins. Zusätzlich schutzt eine ESD-Diode die empfind- ¨ lichen Datenleitungen (D+/D−) vor Uberspannung oder elektrostatischer Entladung. ¨

### 3.6 PIN-ZUORDNUNG UND EXTERNE SCHNITTSTELLEN

Um die Position besser regeln zu können, wird außerdem die Rotation der Motoren uber Encoder ¨ erfasst. Jeder Motor hat dazu zwei Channels, sodass auch die Drehrichtung erfasst werden kann. Allerdings liefern die Encoder ein Signal mit einer Amplitude von 5V, während die Eingänge am STM32 mit einem Spannungsniveau von 3.3V arbeiten. Um das Spannungsniveau anzupassen, wurde ein Spannungsteiler konzipiert. Die Frequenz des Signals ist gering genug, sodass die parasitären Eigenschaften dieser Schaltung nicht signifikant sind.

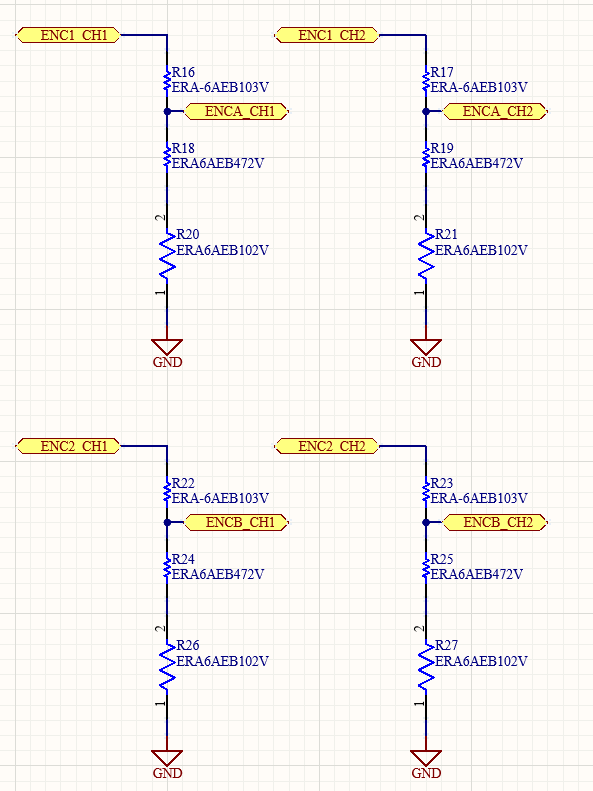
[picture p23: figure]

Abbildung 3.22: Encoder Spannungsteiler

Die Spannung am Eingang des STM32 ergibt sich bei dieser Schaltung:

Ustm = 5V ·

R2+R3
R1+R2+R3

= 5V ·

4.7kΩ+1kΩ
10kΩ+4.7kΩ+1kΩ = 3.2V

Um in Zukunft eine Erweiterung mit Sensoren oder weiteren Aktoren zu ermöglichen, wurden zahl-
reiche Schnittstellen uber Pins nach außen gef ¨ | uhrt. Dabei wurde darauf geachtet, dass von jedem ¨
relevanten Protokoll entsprechende Pins ausgefuhrt sind. Falls diese Schnittstellen nicht gebraucht ¨ werden, können die Pins auch als GPIOs genutzt werden.

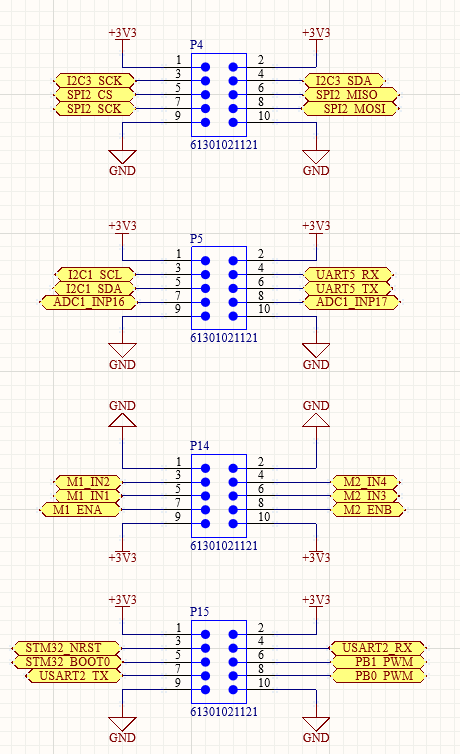
[picture p24: figure]

Abbildung 3.23: Pinout fur Erweiterungen ¨

# 4 PCB Design

Zur besseren Ubersichtlichkeit und zur Vereinfachung kommender Arbeitsschritte, haben wir uns ¨ fur eine klare Trennung von verschiedenen Bereichen auf der Platine entschieden. Nach der syste- ¨ matischen Zuordnung aller Komponenten entschieden wir uns fur einen Vier-Layer-Aufbau, da bei ¨ mehreren Bauteilen eine hohe Anzahl an Signalkontakten genutzt wird.
Die beiden inneren Layer wurden jeweils als durchgehende Polygone fur die Betriebsspannung (3.3V) ¨ und Masse (GND) vorgesehen. Dadurch kann die Spannungsversorgung uber einfache Vias an beliebi- ¨ gen Stellen angebunden werden, was sowohl die Platzierung als auch das Routing deutlich erleichtert.

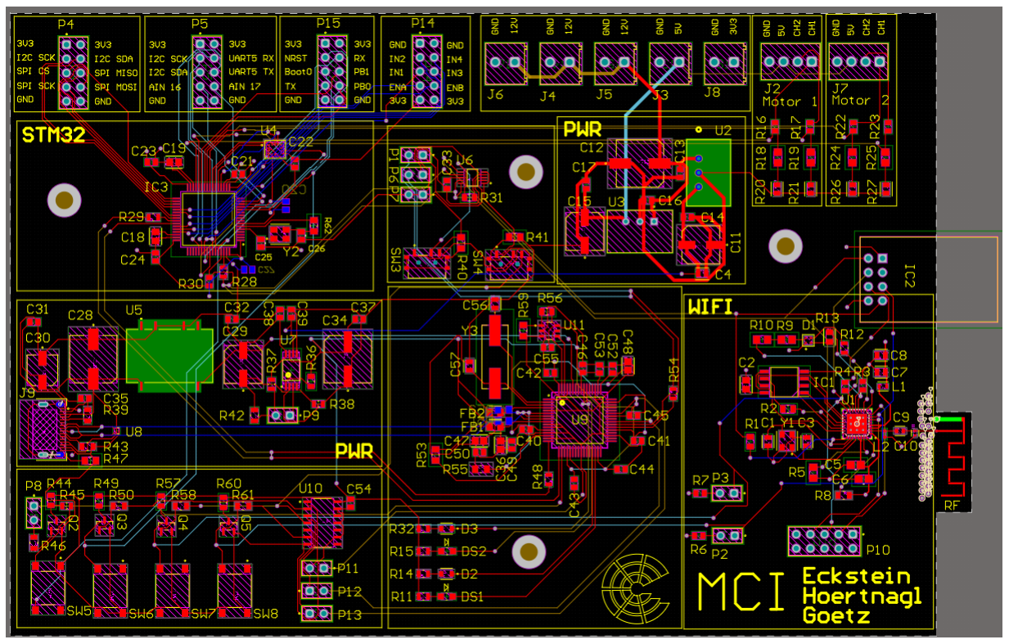
[picture p25: figure]

Abbildung 4.1: PCB Design

### 4.1 STECKER UND SCHNITTSTELLEN

P4, P5, P15: | Reserve fur zuk ¨ | unftige Erweiterungen ¨
P14: | Signale fur die H-Br ¨ | ucke, zur Ansteuerung der Motoren ¨
J3-6, J8: | Schraubklemmen fur externe 12V, sowie Anschluss der Peripherie ¨
J2, J7: | Encoder Signale der Motoren

### 4.2 STM32

Beim Layout des PCB um den STM32 wurden zunächst alle Komponenten platziert. Dabei wurde
insbesondere darauf geachtet, dass die Keramikkondensatoren nah an den Anschlussen f ¨ | ur die Versor- ¨
gungsspannung liegen. Anderenfalls wurde der Widerstand und die Induktivit ¨ | ät der Leiterbahnen den
Effekt der Kondensatoren zu sehr mindern. Dies gilt auch fur den externen Oszillator, der ebenfalls ¨
nah an den Anschlussen platziert wurde. Aus Platzgr ¨ | unden wurden einige der Kondensatoren auf ¨
der Ruckseite der Platine platziert. das erm ¨ | öglicht ein sauberes Routing und die Kondensatoren sind
trotzdem nah genug an den Versorgungspins.
Anschließend konnten die Pins zu den Steckern P4, P5, P14, P15 ausgefuhrt werden. Dabei wurde ¨ je ein Layer pro Stecker verwendet, um das Tracing sauberer zu gestalten.

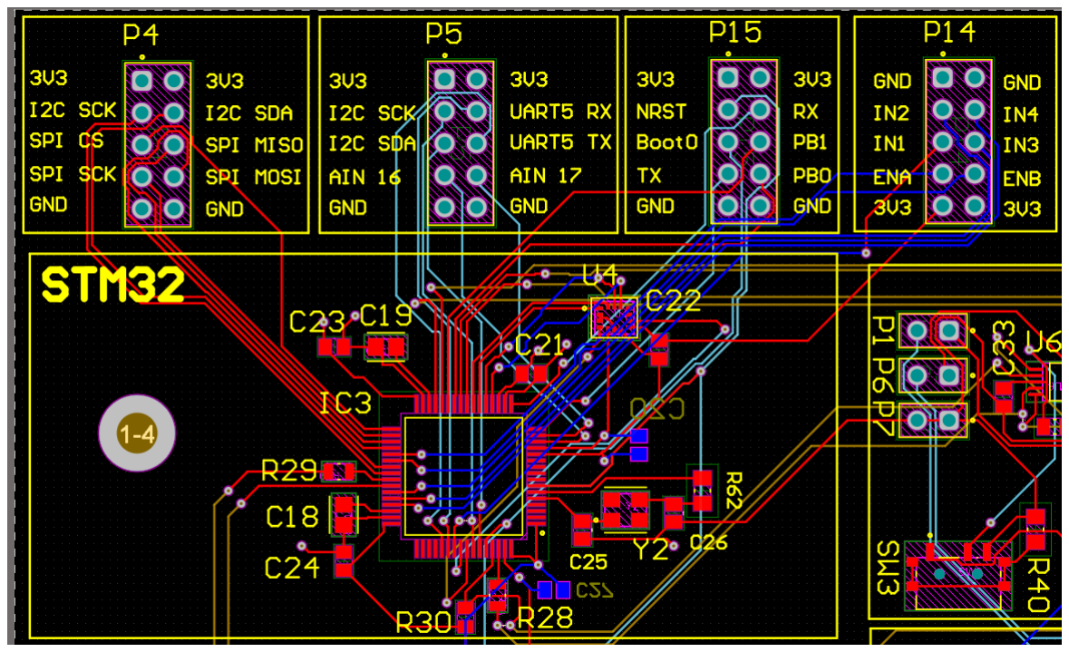
[picture p26: figure]

Abbildung 4.2: STM32 PCB Layout

### 4.3 UART UMSCHALTUNG

Bei der Umsetzung der UART-Umschaltung mittels analogem Multischalter wurde besonders auf eine kompakte und zentralisierte Platzierung geachtet. Zudem war es wichtig, die zugehörigen Schalter gut zugänglich und in direkter Nähe zueinander anzuordnen, um eine intuitive Bedienung zu ermöglichen. Wie bei allen Versorgungspins wurde auch hier darauf geachtet, den Keramikkondensator möglichst nah am Versorgungseingang des MUX zu platzieren, um eine stabile Spannungsversorgung sicherzustellen.

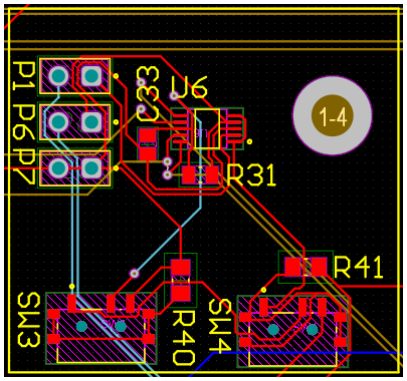
[picture p27: figure]

Abbildung 4.3: PCB UART Umschaltung

### 4.4 PWR BATTERIE

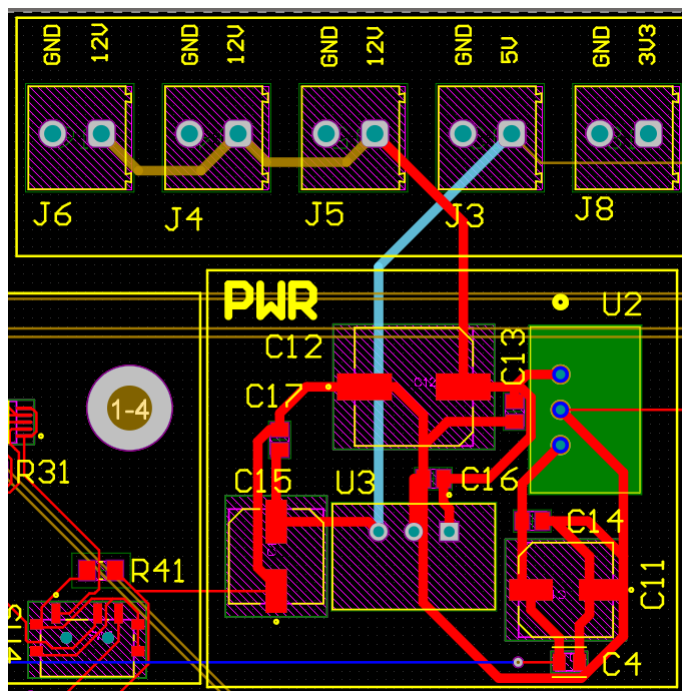
[picture p28: figure]

Abbildung 4.4: PCB Batterie PWR

Die Spannungswandler und Kondensatoren wurden nah an den Schraubklemmen platziert, um die Leiterbahnen mit hoher Strombelastung kurzer zu halten. Außerdem wurde die Breite der Leiterbah- ¨ nen erhöht, um die Stromtragfähigkeit zu gewährleisten.
Die H-Brucke um die Motoren zu treiben, wird ¨ | uber den Anschluss J4 mit der Versorgungsspannung ¨
verbunden. Somit ist an dieser Stelle mit höheren Strömen zu rechnen.

### 4.5 PWR USB UND POWER MUX

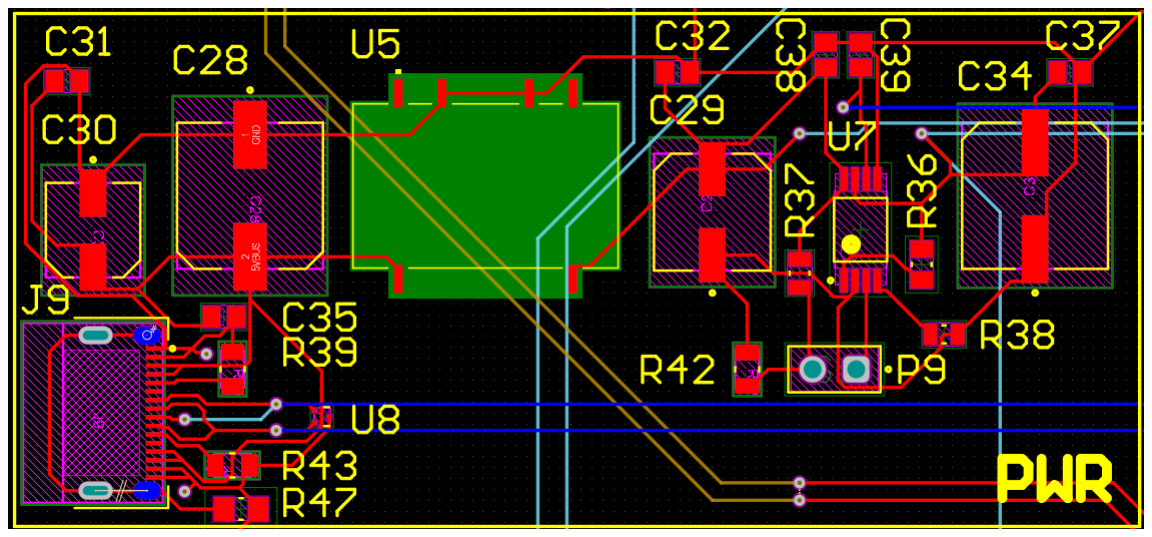
[picture p29: figure]

Abbildung 4.5: USB Schnittstelle und Spannungsumschaltung

Das gezeigte PCB-Layout zeigt den Bereich der USB-Versorgung sowie die automatische Umschaltung zwischen den beiden 3.3V-Versorgungszweigen mittels Power-MUX (TPS2113A). Die USB-C-Schnittstelle (links unten) liefert bis zu 1.5A und wurde aufgrund ihrer symmetrischen Bauform gewählt, wodurch das Einstecken unabhängig von der Orientierung möglich ist. Die Spannungsregulation auf 3.3V erfolgt uber einen leistungsstarken DC/DC-Wandler (U5). Zur Stabilisierung der ¨ Spannungsversorgung wurden jeweils Elektrolyt- und Keramikkondensatoren direkt an den Ein- und Ausgängen platziert. Der MUX (U7) befindet sich zentral, der Konfigurationsjumper (P9) erlaubt die
Priorisierung des Versorgungspfads. Die Masseflächen sind großzugig ausgef ¨ | uhrt und verbessern die ¨
EMV-Eigenschaften sowie die Stromtragfähigkeit.

### 4.6 USB-UART WANDLER

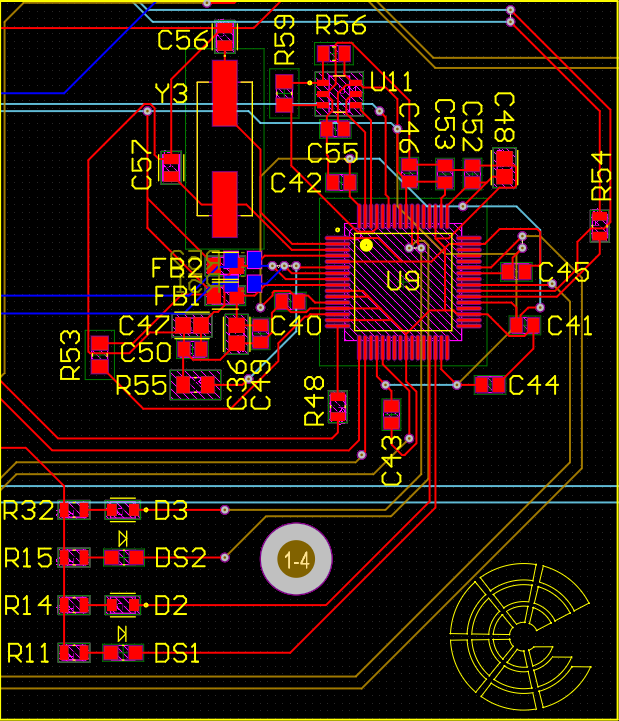
[picture p30: figure]

Abbildung 4.6: PCB FTDI Schaltung

Die Abbildung zeigt den zentralen Bereich der Kommunikationsschnittstelle, rund um den FTDI-Chip
(U9), der als USB-zu-Dual-UART-Brucke fungiert und somit eine Schl ¨ | usselrolle bei der seriellen Kom- ¨
munikation zwischen PC, STM32 und ESP8266 ubernimmt. Der Baustein wurde bewusst m ¨ | öglichst
zentral auf der Platine positioniert, um kurze und ubersichtliche Leitungswege zu gew ¨ | ährleisten.

Besonderes Augenmerk wurde auf die korrekte Platzierung der Entkopplungskondensatoren gelegt. Zahlreiche Keramikkondensatoren wurden gemäß Designguideline so nahe wie möglich an den jeweiligen Versorgungspins platziert, um eine stabile Spannungsversorgung bei schnellen Lastwechseln
sicherzustellen. Aus Platzgrunden mussten zwei Widerst ¨ | ände auf die Ruckseite der Platine verlagert ¨
werden.

Auch der Schwingquarz (Y3) wurde möglichst nahe an den entsprechenden Pins des FTDI-Chips positioniert, um ein sauberes Taktsignal ohne Störungen zu gewährleisten. Die UART-Signalleitungen sind mit Status-LEDs (DS1, DS2, D2, D3) ausgestattet, die die Aktivität der RX- und TX-Leitungen visuell darstellen und somit beim Debugging unterstutzen. ¨

### 4.7 LEITERPLATTENDESIGN FUR EIN STANDALONE ESP8266EX-MODUL ¨

Fur den Entwurf eines eigenst ¨ | ändigen ESP8266EX-Moduls gelten spezielle Designvorgaben bezuglich ¨
der Stromversorgung, des Quarzoszillators, der HF-Leitungsfuhrung und der Masseanbindung. Die ¨ Versorgungsspannung beträgt 3.3V, die Stromversorgungsleitungen besitzen eine Mindestbreite von 15 mil.

Die Eingangs- und Ausgangskondensatoren am Oszillator sind seitlich neben dem Chip positioniert und nicht direkt in der Leitung. Zudem wurden keine hochfrequenten digitalen Signale unter dem
Quarz gefuhrt und es wurden keine st ¨ | örenden Bauteile wie Schaltregler oder Spulen in unmittelbarer
Nähe verbaut.

Die Antennenanbindung wurde möglichst kurz ausgefuhrt und mit vielen Masse-Vias abgeschirmt. ¨ Es wurden auch keine Biegungen in den Antennenleitungen umgesetzt. Hochfrequente Signale wie SDIO CLK oder UART wurden nicht in der Nähe der Antenne platziert. Die freistehende PCB-Antenne wurde außerhalb des regulären Boards angebracht, ohne Masse- und Versorgungsebene. Zudem ist die Antenne möglichst weit von anderen Störquellen entfernt.

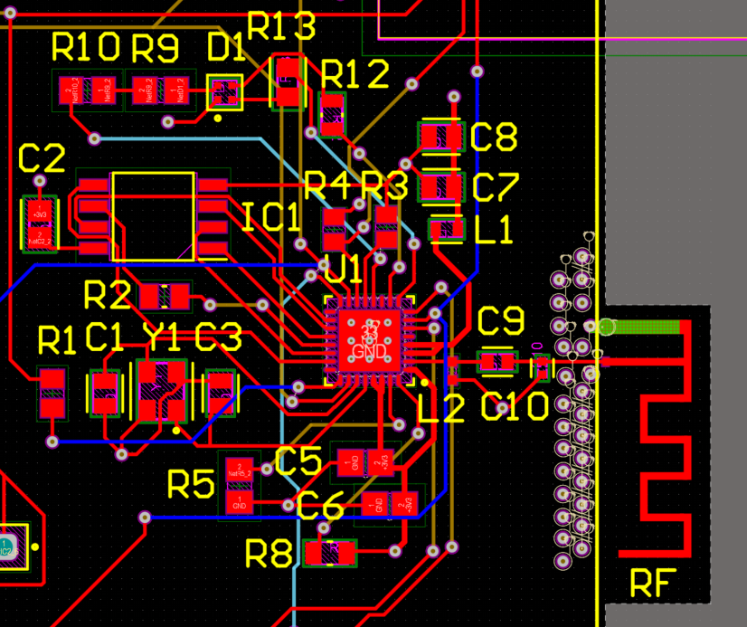
[picture p31: figure]

Abbildung 4.7: PCB-Layout WiFi

### 4.8 BACKUP LOSUNG ¨

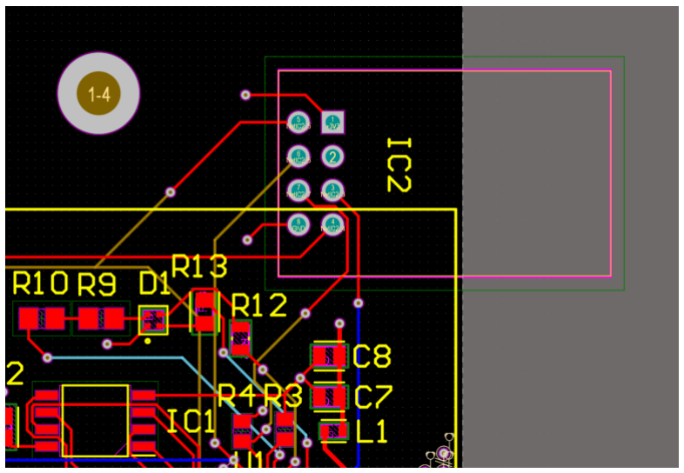
[picture p32: figure]

Abbildung 4.8: Backup WiFi-Kommunikation PCB

Als vollständige Backup-Lösung wurde, wie beschrieben, der ESP01 verwendet. Dieser kann mit den
bestehenden Pins in den dafur vorgesehenen Footprint eingel ¨ | ötet werden. Dabei wurde die gleiche
Anbindung wie bei der regulären Variante an die UART-, Reset- und Enable-Pins vorgesehen.

### 4.9 BOOTLOADER AKTIVIERUNG

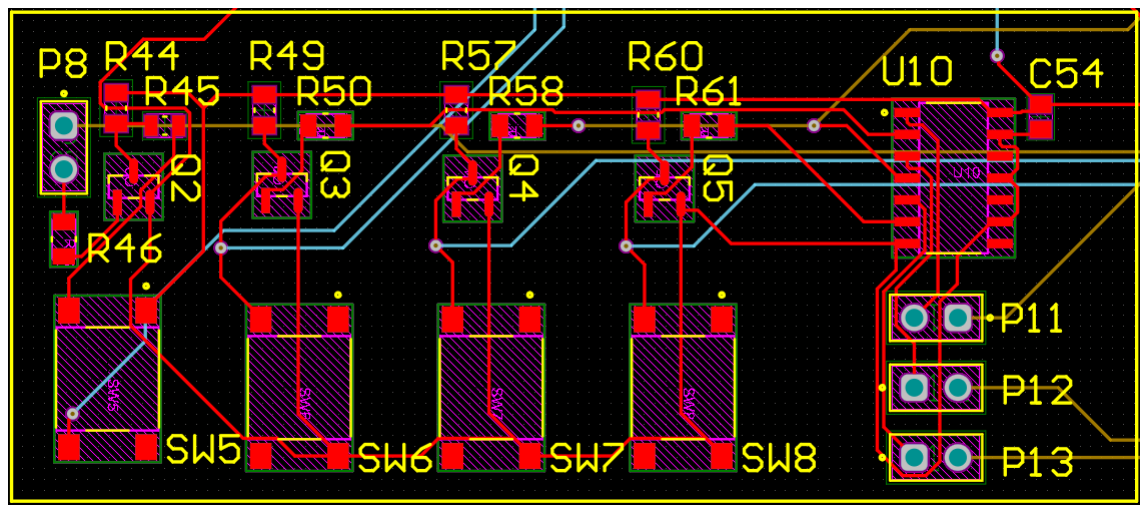
[picture p33: figure]

Abbildung 4.9: Bootloaderschaltung PCB

Die Bootloader-Aktivierungsschaltung wurde aus Grunden der ¨ | Ubersichtlichkeit m ¨ | öglichst symme-
trisch und kompakt aufgebaut. Alle zugehörigen Bedienelemente – jeweils ein Reset- und Boot-Taster fur STM32 und ESP8266 – wurden bewusst nebeneinander an einem Ort platziert, um eine intuitive ¨ Bedienung zu ermöglichen. Aufgrund von Platzmangel wurde im finalen Layout von der ursprunglich ¨ vertikalen auf eine horizontale Anordnung gewechselt.

Die Transistorschaltungen (Q2–Q5) dienen der entkoppelten Signalweiterleitung zwischen FTDI-Chip
und Ziel-MCUs, während der Inverter (U10) fur die korrekte Logiksteuerung ben ¨ | | ötigt wird. Die
Jumper erlauben bei Bedarf die Deaktivierung der automatischen Bootlogik oder den Anschluss eines externen Programmieradapters. Eine nachträgliche manuelle Beschriftung der Taster ist vorgesehen, da dies im Layoutprozess versäumt wurde.

# 5 Mechanischer Aufbau

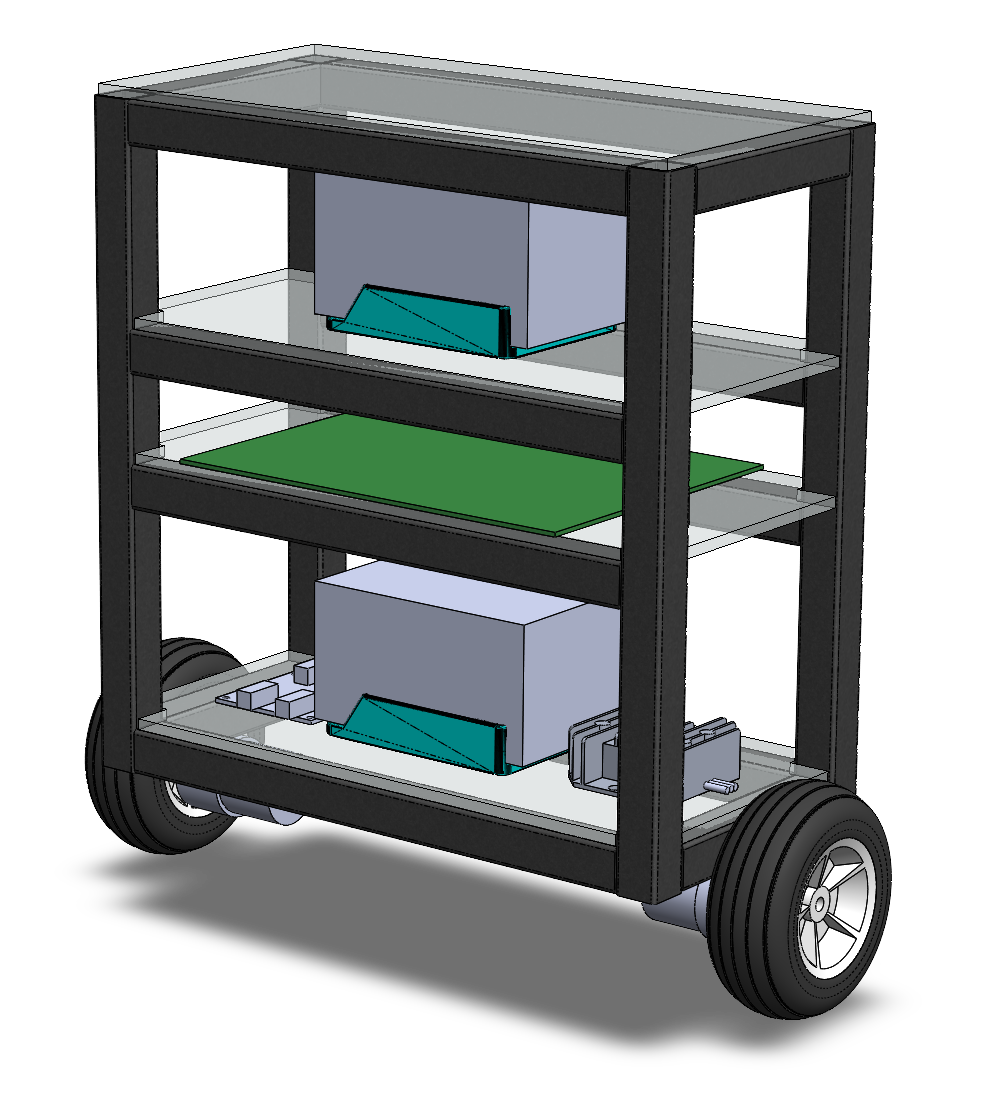
[picture p34: figure]

Abbildung 5.1: Konstruktion

Die Konstruktion besteht aus einem mehrstufigen Rahmengehäuse, in dem die elektronischen Komponenten und der mechanische Antrieb verbaut sind. Die Böden bilden hierbei 5 mm dicke Plexiglasplatten.

### 5.1 RAHMENSTRUKTUR

Die Rahmenstruktur besteht aus ITEM-Profilen mit den Abmessungen 20 x 20 mm. Diese werden mit systemspezifischen Verbindungsschrauben und Nutensteinen miteinander verbunden. Die Struktur bietet die Möglichkeit, offen auf das System zuzugreifen und die Position der Akkus zu wechseln, um den Schwerpunkt der Anwendung anzupassen.

### 5.2 EBENE 0

Die grundlegende Mechanik, bestehend aus Motoren und Rädern, wird auf der Unterseite der Konstruktion mithilfe von 3D-gedruckten Halterungen umgesetzt. Die Reifen haben einen Durchmesser von 10 cm und werden an den Motorenachsen befestigt.

### 5.3 EBENE 1

Zur Ansteuerung der Gleichstrommotoren kommt ein kompakter Motortreiber auf einer kleinen, separaten Platine zum Einsatz. Dieser ist auf der untersten Ebene des Aufbaus untergebracht und
ubernimmt die Leistungsansteuerung der Antriebsmotoren. Ebenso wie eine der beiden m ¨ | öglichen
Positionen, an denen der Akku der Anwendung platziert werden kann. Der DC/DC-Wandler vervollständigt die Ebene.

### 5.4 EBENE 2

Diese Ebene ist vollständig fur das PCB vorgesehen. Hierbei werden Kabel durch die Plexiglasplatten ¨
gefuhrt und nach der Vormontage mithilfe von Kabeldurchf ¨ | uhrungen verbaut. ¨

### 5.5 EBENE 3

Auf dieser Ebene befindet sich die zweite, erhöhte Position des Akkus der Anwendung. Ein erhöhter Schwerpunkt erleichtert die Regelung und sorgt somit fur ein gutes Ergebnis. ¨

### 5.6 EBENE 4

Diese Ebene ist vollständig fur sp ¨ ätere Erweiterungen vorgesehen, zu denen unter anderem Kameras und weitere Sensoren gehören.

### 5.7 ABMESSUNGEN

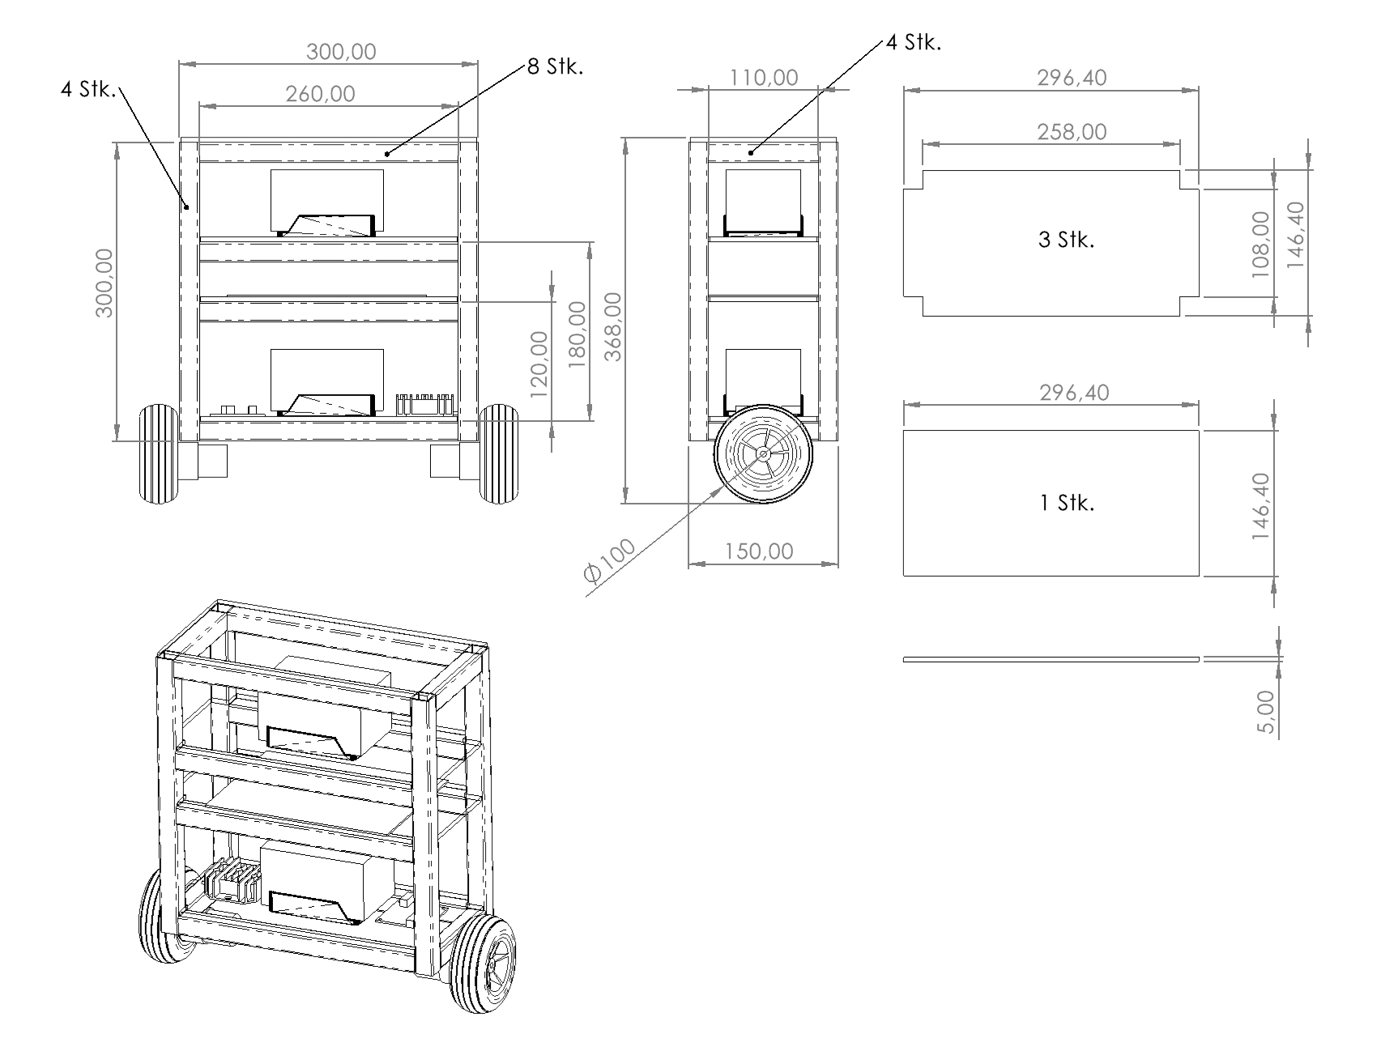
[picture p35: figure]

Abbildung 5.2: Abmessungen Gehäuse

Die Außenmaße des Rahmens betragen dabei 30 cm in der Länge, 150 cm in der Tiefe und 30 cm in der Höhe. Damit ist er kompakt und leicht zu transportieren.

# 6 Kostenkalkulation

Im Rahmen der Projektzwischenphase wurde eine detaillierte Kostenabschätzung der aktuell geplan-
ten Bauteile und Komponenten durchgefuhrt. Die in Tabelle 6.1 aufgef ¨ | uhrten Positionen basieren auf ¨
einer finalen Auswahl aller relevanten elektrischen und mechanischen Komponenten, wie sie in der endgultigen Umsetzung vorgesehen sind. Obwohl die Bestellung zum aktuellen Zeitpunkt noch nicht ¨
erfolgt ist, wird mit keiner wesentlichen Anderung der Bauteilliste mehr gerechnet. Kosten f ¨ | ur mecha- ¨
nische Rahmenprofile und Plexiglasscheiben wurden nicht berucksichtigt, da diese ¨ | uber hausinterne ¨
Ressourcen zur Verfugung gestellt werden. ¨
Pos. | Bauteil | Beschreibung | ungefähre Kosten (€)
01 | PCB | 4-Layer PCB | 85,00
02 | PCB-Komponenten | alle Chips und Bauteile, die auf
die Platine gelötet werden

100,00

03 | Räder | Rad 100mm mit Kugellager (2x) | 30,00
04 | Motor | 12V DC-Getriebemotor mit En-
coder 90:1, 38kgcm (2x)

65,00

05 | Motordriver | Dual-Channel DC Motor Driver
12A PWM

35,00

06 | Akku | Makita | Akku | BL1840B
18V/4Ah Li-Ion

80,00

07 | DC/DC-Wandler | Bauer | Electronics | DC-DC
18V–36V zu 12V, 10A, 120W

20,00

08 | ESP01 | ESP8266 ESP-01S WiFi Modul | 5,00
09 | Akkuadapter | QUPERR Adapter mit Siche-
rung und Schalter (2x)

20,00

Gesamtkosten | 440,00
| Tabelle 6.1: Stuckliste mit Komponenten und ungef ¨ | | | ähren Einzelkosten
Das ursprunglich vorgesehene Budget von 400 ¨ | | € wird nach aktuellem Stand mit den geplanten Ge-
samtkosten von 440€ geringfugig ¨ | uberschritten. Diese ¨ | Uberschreitung ist vor allem auf folgende ¨
Punkte zuruckzuf ¨ | uhren: ¨
- Der Einsatz einer 4-Layer-Leiterplatte war aufgrund der hohen Pinanzahl und des komplexen Routings notwendig und verursacht höhere Fertigungskosten als eine herkömmliche 2-Layer-Platine.
- Die gewählten DC-Getriebemotoren mit hohem Drehmoment sind kostenintensiver, erfullen ¨ jedoch die mechanischen Anforderungen des Systems zuverlässig.
- Der vorgesehene Makita-Akku mit integriertem Batteriemanagementsystem bietet hohe Sicherheit und Komfort, bringt jedoch auch erhöhte Anschaffungskosten mit sich.
- Einige spezifische Leiterplattenkomponenten wie der STM32-Mikrocontroller sind aufgrund ihrer Leistungsfähigkeit vergleichsweise teuer. Gleiches gilt fur den DC/DC-Wandler TSRN1- ¨ 2433SM, der aufgrund seiner Fähigkeit, auch bei nur 5V Eingangsspannung ausreichend Strom auf 3.3V bereitzustellen, fur die Spannungsversorgung des Systems essenziell ist. ¨

In Summe erscheinen die prognostizierten Ausgaben angesichts der gewählten Architektur und Zielanforderungen nachvollziehbar und sinnvoll.

# 7 Pinbelegung und Funktionszuordnung

Pin | Funktion | Beschreibung | Bemerkung
PA0 | ADC1 INP16 | reserve pin
PA1 | ADC1 INP16 | reserve pin
PA2 | USART2 TX | reserve pin
PA3 | USART2 RX | reserve pin
PA4 | SPI1 CS | lagesensor
PA5 | SPI1 SCK | lagesensor
PA6 | SPI1 MISO | lagesensor
PA7 | SPI1 MOSI | lagesensor
PA8 | I2C3 SCK | Reserve Pin
PA9 | USART1 RX | for flashing
PA10 | USART1 TX | for flashing
PA11 | M1 IN2 | in Motor 1
PA12 | M2 IN3 | in Motor 2
PA13 | M2 IN4 | in Motor 2
PA14
PA15
PB0 | PWM | Reserve pin | tim3 ch3
PB1 | PWM | Reserve pin | tim3 ch4
PB2 | ENC2 CH1 | Encoder 2
PB3 | M1 IN1 | in Motor 1
PB4 | lsm int2 | Interrupt 2 sensor
PB5 | lsm int1 | Interrupt 1 sensor
PB6 | I2C1 SCL | reserve pin
PB7 | I2C1 SDA | reserve pin
PB8 | UART4 RX | for Esp
PB9 | UART4 TX | for Esp
PB10 | ENC2 CH2 | Encoder 2
PB11
PB12 | SPI2 CS | reserve pin
PB13 | SPI2 SCK | reserve pin
PB14 | SPI2 MISO | reserve pin
PB15 | SPI2 MOSI | reserve pin
PC0
PC1
PC2
PC3
PC4 | ENC1 CH1 | Encoder 1
PC5 | ENC1 CH2 | Encoder 1
PC6 | M1 ENA | PWM Motor 1 | tim3 ch1
PC7 | M2 ENB | PWM Motor 2 | tim3 ch2
PC8
PC9 | I2C3 SDA | reserve pin
PC10
PC11
PC12 | UART5 TX | reserve pin
PC13
PC14
PC15
PD2 | UART5 RX | reserve pin

Tabelle 7.1: Pinbelegung und Funktionen

# Abbildungsverzeichnis

0.1 Entwurf inverses Pendel | | II
2.1 UART Topologie | | 2
3.1 STM32 mit Quarz und Kondensatoren | | 3
3.2 LSM6DSOX | | 4
3.3 FTDI-Chip mit Peripherie | | 5
3.4 UART-Signalumschaltung | | 6
3.5 Bootloader-Schaltung | | 7
3.6 PCB Abschnitt WiFi | | 9
3.7 Stromversorgung ESP8266 | | 10
3.8 Stromversorgung Antenne | | 10
3.9 Antenne | | 11
3.10 Flash Beschaltung ESP8266 | | 12
3.11 ESP Oszillator | | 12
3.12 WiFi Backup | | 13
3.13 Backup - ESP01[6] | | 13
3.14 LED Schaltplan | | 13
3.15 Pegel wichtiger Pins ESP8266 | | 14
3.16 Breakout Pins ESP8266 | | 15
3.17 Energieversorgungsschema | | 16
3.18 automatische Spannungsumschaltung | | 16
3.19 USB Spannungsversorgung | | 17
3.20 Spannungsversorgung durch Batterie | | 17
3.21 USB-C Schnittstelle | | 18
3.22 Encoder Spannungsteiler | | 19
3.23 Pinout fur Erweiterungen | ¨ | 19
4.1 PCB Design | | 20
4.2 STM32 PCB Layout | | 21
4.3 PCB UART Umschaltung | | 21
4.4 PCB Batterie PWR | | 22
4.5 USB Schnittstelle und Spannungsumschaltung | | 22
4.6 PCB FTDI Schaltung | | 23
4.7 PCB-Layout WiFi | | 24
4.8 Backup WiFi-Kommunikation PCB | | 24
4.9 Bootloaderschaltung PCB | | 25
5.1 Konstruktion | | 26
5.2 Abmessungen Gehäuse | | 27

V

# Tabellenverzeichnis

2.1 Technische Daten | | 2
6.1 Stuckliste mit Komponenten und ungef ¨ | ähren Einzelkosten | | 28
7.1 Pinbelegung und Funktionen | | 29

VI

# Literaturverzeichnis

[1] Matthias Gfall, “Hardwareseitige entwicklung eines mobilen inversen pendels. produktentwicklung 1,” Aufgabenstellung, MCI, Innsbruck, 14.02.2025.
[2] Espressif Systems, “Esp8266 datasheet,” Online, 2025. [Online]. Available: https://www.espressif.com/sites/default/files/documentation/0a-esp8266ex datasheet en.pdf
[3] ——, “Esp8266 hardware-deisgn-guide: Hardware design guidelines version 2.8,” Online, 2025. [Online]. Available: https://www.espressif.com/sites/default/files/documentation/esp8266 hardware design guidelines en.pdf (https://www.espressif.com/sites/default/files/documentation/esp8266_hardware_design_guidelines_en.pdf)
[4] Mouser | Electronics, | Inc., | “W25q128jveiq | tr: | Nor | flash | spiflash, | 3v,
128m-bit, | 4kb | uniform | sector,” | Online, | 2025. | [Online]. | Available:
https://eu.mouser.com/ProductDetail/Winbond/W25Q128JVEIQ-TR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 source= bing&utm medium=cpc&utm campaign=DSAs+Other+Suppliers+Austria+English&
utm term=%2FProductDetail%2F&utm content=Other+Suppliers+DSAs%3A+PDP (https://eu.mouser.com/ProductDetail/Winbond/W25Q128JVEIQ-TR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)
[5] ——, | “Abm8-26.000mhz-10-1-u-t: | Oszillator,” | Online, | 2025. | [Online]. | Availa-
ble: | https://eu.mouser.com/ProductDetail/ABRACON/ABM8-26.000MHZ-10-1-U-T?qs=
76dmnhCH%2FMP1JRP6EvWbSw%3D%3D&msclkid=535646f8f811166bd1e32e996b76dd5d& utm source=bing&utm medium=cpc&utm campaign=DSAs%20Other%20Suppliers% 20Austria%20English&utm term=%2FProductDetail%2F&utm content=Other%20Suppliers% 20DSAs%3A%20PDP (https://eu.mouser.com/ProductDetail/ABRACON/ABM8-26.000MHZ-10-1-U-T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)
[6] reichelt elektronik GmbH, “Entwicklerboards - esp8266 wifi-modul: Debo esp8266,” Online, 2025. [Online]. Available: https://www.reichelt.de/de/de/shop/produkt/entwicklerboards - esp8266 wifi-modul-192142 (https://www.reichelt.de/de/de/shop/produkt/entwicklerboards_-_esp8266_wifi-modul-192142)

VII
