Stefmci/ELEK_Inv_Pen/Komponenten und Auslegung/Komponenten_aus_BOM_Vergleich.xlsx

 | Name | Beschreibung | Designator | Menge | Hersteller | Hersteller Nummer
ausgetauscht zu 0805 | C0603C100C5GACTU | 10pF 50V 0603 KerKo | C1, C3 | 2 | KEMET | C0603C100C5GACTU
 | 08051C104KAT2A | 100nF 100V 0805 KerKo | C2 | 1 | Kyocera AVX | 08051C104KAT2A
 | GRM21BR61C106KE15L | 10µF 16V 0805 KerKo | C4 | 1 | Murata | GRM21BR61C106KE15L
 | C0805C105K5RACTU | 1µF 50V 0805 KerKo | C5, C6 | 2 | KEMET | C0805C105K5RACTU
 | C0805C106K8PACTU | 10µF 10V 0805 KerKo | C7 | 1 | KEMET | C0805C106K8PACTU
 | C0805C104J8RACTU | 100nF 10V 0805 KerKo | C8 | 1 | KEMET | C0805C104J8RACTU
 | C0603C829C5GACTU | 8.2pF 50V 0603 KerKo | C9 | 1 | KEMET | C0603C829C5GACTU
 | CBR04C249B5GAC | 2.4pF 50V 0402 KerKo | C10 | 1 | KEMET | CBR04C249B5GAC
ausgetauscht zu 50V | EEEFK1C470UR | 47µF 16V Al ELCO | C11, C15, C29 | 3 | Panasonic | EEE-FK1C470UR
 | EEEFT1H221AP | 220µF 50V Al ELCO | C12 | 1 | Panasonic | EEE-FT1H221AP
 | Capacitor 100 nF +/-10% 50 V 0805 | 100nF 50V 0805 KerKo | C13, C14, C16, C17, C20, C21, C22, C23, C24, C27, C31, C32, C33, C35, C37, C38, C39, C40, C41, C42, C43, C44, C45, C46, C49, C50, C52, C53, C54, C55 | 30 | Yageo | CC0805KRX7R9BB104
 | 0805ZD225KAT2A | 2.2µF 10V 0805 KerKo | C18, C19 | 2 | Kyocera AVX | 0805ZD225KAT2A
 | 08055A150JAT2A | 15pF 50V 0805 KerKo | C25, C26 | 2 | Kyocera AVX | 08055A150JAT2A
 | EEEFK1H101P | 100µF 50V Al ELCO | C28 | 1 | Panasonic | EEE-FK1H101P
 | EEE-FK1H100UR | 10µF 50V Al ELCO | C30 | 1 | Panasonic | EEE-FK1H100UR
 | EEE-FC1H220P | 22µF 50V Al ELCO | C34 | 1 | Panasonic | EEE-FC1H220P
 | C2012X5R1H475K125AB | 4.7µF 50V 0805 KerKo | C36, C47, C48 | 3 | TDK | C2012X5R1H475K125AB
 | C0805C270J5GACTU | 27pF 50V 0805 KerKo | C56, C57 | 2 | KEMET | C0805C270J5GACTU
 | SML-LX0404SIUPGUSB | LED RGB CLEAR SMD | D1 | 1 | Lumex | SML-LX0404SIUPGUSB
 | SML-LXT0805IW-TR | LED RED DIFFUSED SMD | D2, D3 | 2 | Lumex | SML-LXT0805IW-TR
 | SML-LXT0805GW-TR | LED, GREEN, 565 nm, 2 V, -25 to 80 degC, 2-Pin SMD, RoHS, Tape and Reel | DS1, DS2 | 2 | Lumex | SMLLXT0805GWTR
 | HZ0805E601R-10 | FERRITE BEAD 600 OHM 0805 1LN | FB1, FB2 | 2 | Laird | HZ0805E601R-10
ausgetauscht zu COM-15809 | W25Q128JVSQ | Integrated Circuit | IC1 | 1
in Zukaufteile | ESP-01 | Integrated Circuit | IC2 | 1
 | STM32H7A3RIT6 | Integrated Circuit | IC3 | 1
 | 691210910004 |  | J2, J7 | 2 | Wurth Electronics | 691210910004
 | 691214110002 |  | J3, J4, J5, J6, J8 | 5 | Wurth Electronics | 691214110002
 | 213083-0005 | CONN RCP USB2.0 TYP C 24P SMD RA | J9 | 1 | Molex | 213083-0005
 | LQW18AN4N3C00D | Wire Wound RF Inductor 4.3nH ±0.2nH 850mA 0.059Ω 0603 (1608) | L1 | 1 | Murata | LQW18AN4N3C00D
 | 7447840015G | 7447840015G Multilayer Inductor, 1.5Nh, 0.3A, 0402 Rohs Compliant: Yes |Wurth Elektronik 7447840015G | L2 | 1 | Wurth Electronics | 7447840015G
 | 61300211121 |  | P1, P2, P3, P6, P7, P8, P9, P11, P12, P13 | 10 | Wurth Electronics | 61300211121
 | 61301021121 |  | P4, P5, P10, P14, P15 | 5 | Wurth Electronics | 61301021121
 | BSS138 | MOSFET N-CH 50V 220MA SOT-23 | Q2, Q3, Q4, Q5 | 4 | ON Semiconductor / Fairchild | BSS138
 | TNPW0805499RBEEN | 499 Ohm 0805 0.1% Tol. | R1 | 1 | Vishay Dale | TNPW0805499RBEEN
 | CRCW0805200RFKEA | 200 Ohm 0805 1% Tol. | R2 | 1 | Vishay | CRCW0805200RFKEA
 | ERA-6AEB103V | 10k Ohm 0805 0.1% Tol. | R3, R4, R6, R7, R16, R17, R22, R23, R30 | 9 | Panasonic | ERA-6AEB103V
 | ERJ6ENF1202V | 12k Ohm 0805 1% Tol. | R5 | 1 | Panasonic | ERJ-6ENF1202V
 | RN73C2A12KBTG | 12k Ohm 0805 0.1% Tol. | R8 | 1 | TE Connectivity | RN73C2A12KBTG
 | ERA6AEB101V | 100 Ohm 0805 0.1% Tol. | R9 | 1 | Panasonic | ERA-6AEB101V
 | ERJ-6ENF24R9V | 24.9 Ohm 0805 1% Tol. | R10 | 1 | Panasonic | ERJ-6ENF24R9V
 | CRCW080522R0FKEA | 22 Ohm 0805 1% Tol. | R12 | 1 | Vishay | CRCW080522R0FKEA
 | ERJ-6ENF4990V | 499 Ohm 0805 1% Tol. | R13 | 1 | Panasonic | ERJ-6ENF4990V
 | ERA6AEB472V | 4.7k Ohm 0805 0.1% Tol. | R18, R19, R24, R25 | 4 | Panasonic | ERA-6AEB472V
 | ERA6AEB102V | 1k Ohm 0805 0.1% Tol. | R20, R21, R26, R27 | 4 | Panasonic | ERA-6AEB102V
 | CRCW080568R0FKEA | 68 Ohm 0805 1% Tol. | R28, R29, R48, R54 | 4 | Vishay | CRCW080568R0FKEA
 | RC0805FR-0710KL | 10k Ohm 0805 1% Tol. | R31, R36, R44, R49, R56, R57, R60 | 7 | Yageo | RC0805FR-0710KL
ausgetauscht zu 0805 | ERA3AEB680V | 68 Ohm 0603 0.1% Tol. | R32, R33, R34, R35 | 4 | Panasonic | ERA-3AEB680V
 | CRCW08054K30FKEA | 4.3k Ohm 0805 1% Tol. | R37 | 1 | Vishay | CRCW08054K30FKEA
 | RC0805FR-07470RL | 470 Ohm 0805 1% Tol. | R38, R45 | 2 | Yageo | RC0805FR-07470RL
 | RN73C2A5K11BTDF | 5.11k Ohm 0805 0.1% Tol. | R39, R43 | 2 | TE Connectivity | RN73C2A5K11BTDF
 | RC0805JR-070RL | 0 Ohm 0805 | R40, R41, R47 | 3 | Yageo | RC0805JR-070RL
 | CRCW08051K50FKEA | 1.5k Ohm 0805 1% Tol. | R42 | 1 | Vishay | CRCW08051K50FKEA
 | RN73C2A100RBTDF | 100 Ohm 0805 0.1% Tol. | R46, R50, R58, R61 | 4 | TE Connectivity | RN73C2A100RBTDF
 | RC0805FR-0710RL | 10 Ohm 0805 1% Tol. | R51, R52 | 2 | Yageo | RC0805FR-0710RL
 | RC0805FR-071KL | 1k Ohm 0805 1% Tol. | R53 | 1 | Yageo | RC0805FR-071KL
 | CRCW080512K0FKEA | 12k Ohm 0805 1% Tol. | R55 | 1 | Vishay | CRCW080512K0FKEA
 | RC0805JR-072KL | 2k Ohm 0805 5% Tol. | R59 | 1 | Yageo | RC0805JR-072KL
 | Resistor 0R +/- 5% 0805 125 mW | 0 Ohm 0805 | R62 | 1 | Yageo | RC0805JR-070RL
 | PCM12SMTR | SWITCH SLIDE SPDT 300MA 6V | SW3, SW4 | 2 | ITT C&K | PCM12SMTR
 | PTS645SM43SMTR92LFS | SWITCH TACTILE SPST-NO 0.05A 12V | SW5, SW6, SW7, SW8 | 4 | ITT C&K | PTS645SM43SMTR92LFS
? | Component_1 |  | U | 1
 | ESP8266EX | Low-Power, Highly-Integrated Wi-Fi Solution, 2.5 to 3.6 V, 80 mA, -40 to 125 degC, 32-Pin QFN | U1 | 1 | Espressif Systems | ESP8266EX
 | TSR 1-2433 |  | U2 | 1 | Traco Power | TSR1-2433
 | TSR 1-2450 | DC/DC converter, 5 VDC, 1000 mA, -40 to 85 degC, 3-Pin SIP, RoHS | U3 | 1 | Traco Power | TSR1-2450
2 Stk. Bestellt | LSM6DSOXTR | INEMO INERTIAL MODULE: 3D ACCELE | U4 | 1 | STMicroelectronics | LSM6DSOXTR
 | TSRN 1-2433SM | TSRN 1-2433SM Non Isolated Board Mount Dc/dc Converter, Surface Mount Dip, 5.5 W, 1.5 V, 5.5 V, 1 A, 4.6 V Rohs Compliant: Yes | U5 | 1 | Traco Power | TSRN1-2433SM
 | TS5A23157DGSR | IC SWITCH DUAL SPDT 10MSOP | U6 | 1 | Texas Instruments | TS5A23157DGSR
 | TPS2113APW | Dual In / Single Out Autoswitching Power Mux, 2.8 to 5.5 V, -40 to 85 degC, 8-pin TSSOP (PW), Green (RoHS & no Sb/Br) | U7 | 1 | Texas Instruments | TPS2113APW
2 Stk. Bestellt | TPD2EUSB30DRTR | ESD Solution for Super-Speed (6 Gbps) USB 3.0 Interface, 2 Channels, -40 to +85 degC, 3-pin SOT (DRT), Green (Rohs & No Sb/Br) | U8 | 1 | Texas Instruments | TPD2EUSB30DRTR
 | FT2232HL-Reel | Dual High Speed USB To Multipurpose UART/FIFO IC, 64-pin LQFP, Tape and Reel | U9 | 1 | FTDI | FT2232HL-REEL
 | SN74LVC14AD | IC INVERTER SCHMITT 6CH 14SOIC | U10 | 1 | Texas Instruments | SN74LVC14AD
 | 93LC56BT-I/OT | IC EEPROM 2K SPI 2MHZ SOT23-6 | U11 | 1 | Microchip | 93LC56BT-I/OT
 | ABM8-26.000MHZ-10-1-U-T | Crystal 26MHz ±10ppm 10pF SMD-4 3.2mm x 2.5mm | Y1 | 1 | Abracon | ABM8-26.000MHZ-10-1-U-T
 | ABM8AIG-24.000MHZ-12-2Z-T3 | Crystal 24MHz ±20ppm (Tol) ±50ppm (Stability) 12pF FUND 50Ω Automotive 4-Pin Ultra Mini-CSMD T/R | Y2 | 1 | Abracon | ABM8AIG-24.000MHZ-12-2Z-T3
ausgetauscht zu Max's Type | ABLS2-12.000MHZ-B4Y-T | Crystal or Oscillator | Y3 | 1
E12-Widerstände 0805 (Summen): | RN73C2A12KBTG | 12k Ohm |  | 3
 | ERA-6AEB103V | 10k Ohm |  | 16
 | ERA6AEB472V | 4.7k Ohm |  | 4
 | CRCW08051K50FKEA | 1.5k Ohm |  | 1
 | ERA6AEB102V | 1k Ohm |  | 5
 | RC0805FR-07470RL | 470 Ohm |  | 2
 | ERA6AEB101V | 100 Ohm |  | 5
 | CRCW080568R0FKEA | 68 Ohm |  | 8
 | CRCW080522R0FKEA | 22 Ohm |  | 1
 | RC0805FR-0710RL | 10 Ohm |  | 2
 |  |  | 47 | 47
E12-KerKo 0805 (Summen): | GRM21BR61H106KE43L | 10µF 50V 0805 KerKo |  | 2
 | C2012X5R1H475K125AB | 4.7µF 50V 0805 KerKo |  | 3
 | CGA4J3X7R1H225K125AE | 2.2µF 50V 0805 KerKo |  | 2
 | C0805C105K5RACTU | 1µF 50V 0805 KerKo |  | 2
 | CC0805KRX7R9BB104 | 100nF 50V 0805 KerKo |  | 32
 | C0805C270J5GACTU | 27pF 50V 0805 KerKo |  | 2
 | 08055A150JAT2A | 15pF 50V 0805 KerKo |  | 2
 | 08055A100JAT2A | 10pF 50V 0603 KerKo |  | 2
 |  |  | 47 | 47
