Stefmci/ELEK_Inv_Pen/Komponenten und Auslegung/Zukaufteile.xlsm

Sheet: Bestellliste
Best. | Gegenstand | Händler | Artikelnummer | Link | Anzahl | Länge in m | Brutto pro VE | Netto pro VE | Brutto ges. | Netto ges. | kg/m | Masse in kg | Notiz
 | Akku | Conrad | 1533184 - U3 | https://www.conrad.at/de/p/makita-bl1840b-197265-4-werkzeug-akku-18-v-4-ah-li-ion-1533184.html | 1 |  | 75.99 € | 63.32 € | 75.99 € | 63.32 € |  |  | Makita Akku BL1840B 18V/4Ah Li-Ion
 | DC-Motor | BerryBase | FIT0403 | https://www.berrybase.at/dfrobot-metall-dc-getriebemotor-mit-encoder-122rpm-90-1-38kg.cm-drehmoment-12v | 2 |  | 31.90 € | 26.58 € | 63.80 € | 53.17 € |  |  | DFRobot DC-Getriebemotor mit Encoder, 122RPM, 90:1, 38Kg.cm Drehmoment, 12V
 | DC-Motor Driver | BerryBase | DFR0601 | https://www.berrybase.at/dfrobot-dual-channel-dc-motor-driver-12a-pwm-6-5-37v-12a-kontinuierlich-70a-spitzenstrom | 1 |  | 35.90 € | 29.92 € | 35.90 € | 29.92 € |  |  | DFRobot Dual-Channel DC Motor Driver-12A, PWM, 6,5-37V, 12A kontinuierlich, 70A Spitzenstrom
 | Spannungs-Wandler | Amazon | - | https://www.amazon.de/Bauer-Electronics-12V-Spannungswandler-120W/dp/B09CYYTRTV?__mk_de_DE=ÅMÅŽÕÑ&sp_csd=d2lkZ2V0TmFtZT1zcF9hdGY | 1 |  | 20.16 € | 16.80 € | 20.16 € | 16.80 € |  |  | Bauer Electronics DC-DC 18V-36V zu 12V Spannungs-Wandler 10A 120W
 | Power Adapter | Amazon | - | https://www.amazon.de/QUPERR-Sicherung-Akku-Adapter-Lithium-Akku-Power-Converter/dp/B0BPRYRGVF?__mk_de_DE=ÅMÅŽÕÑ | 1 |  | 19.15 € | 15.96 € | 19.15 € | 15.96 € |  |  | 2 Pack QUPERR Power Wheel Adapter mit Sicherung & Schalter, Akku-Adapter für Makita 18V Lithium-Akku
 | ESP8266 WiFi-Modul | Reichelt | DEBO ESP8266 | https://www.reichelt.at/at/de/shop/produkt/entwicklerboards_-_esp8266_wifi-modul-192142?PROVID=2807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 | 1 |  | 4.13 € | 3.44 € | 4.13 € | 3.44 € |  |  | ESP8266 ESP-01S WiFi Modul
 |  |  |  |  |  |  |  |  | 219.13 € | 182.61 € |  | 0.0 kg | Summe

Sheet: Übliche Händler
Händler | Beschreibung | Angebot notwendig? | Link | Kategorie | Notiz
Alcom | item-Profile & Verbinder | JA | https://www.alcom-international.de/baukastensystem.html | Mechanisch | selbe Firma wie SMT
Amazon | Diverses | NEIN | https://amazon.de | Diverses | Bestellung nur möglich, wenn Händler eine ordentliche Rechnung stellen kann
Bauhaus | Baumarkt | NEIN | https://www.bauhaus.at/ | Mechanisch | Bar bezahlen & Spesenabrechnung
CNCShop | CNC-Komponenten | JA | https://www.cncshop.at/ | Mechanisch
Conrad | Elektrokomponenten | NEIN | https://www.conrad.at/ | Elektrisch
Contorion | Werkzeug, Betriebsausstattung, etc. | NEIN | https://www.contorion.at/ | Mechanisch
Digikey | Elektrokomponenten | NEIN | https://www.digikey.at/ | Elektrisch
Distrelec | Elektrokomponenten | NEIN | https://www.distrelec.at/ | Elektrisch
DOLD Mechatronik | item-Profile, Motoren, etc. | JA | https://www.dold-mechatronik.de/ | Diverses
Eckstein Komponenten | Elektrokomponenten | JA | https://eckstein-shop.de/Startseite | Elektrisch
Elesa+Ganter | Maschinenelemente, Normteile, etc. | NEIN | https://www.elesa-ganter.at/de/aut | Mechanisch
ELV Elektronik | Elektrokomponenten | JA | https://de.elv.com/ | Elektrisch
Eurocircuits | PCBs & Bestückung | NEIN | https://www.eurocircuits.com/ | Elektrisch
faigle Kunststoffe | Plexiglas/PMMA | JA | https://www.faigle.com/en | Mechanisch
Fix Metall | Fe- & Nicht-Fe-Metalle, Zuschnitt | NEIN | https://www.fixmetall-shop.com/ | Mechanisch
Funkenflug | Laserteile | JA | https://www.funkenflug.co.at/ | Mechanisch | in Kematen
Gemmel Metalle | Fe- & Nicht-Fe-Metalle, Zuschnitt | JA | https://www.gemmel-metalle.de/ | Mechanisch | gezogene Al-Wellen
Haberkorn | Maschinenelemente, item-Profile, etc. | NEIN | https://www.haberkorn.com/ | Mechanisch | Preise nur mit MCI Account sichtbar
Hoffmann | Werkzeug, Betriebsausstattung, etc. | NEIN | https://www.hoffmann-group.com/AT/de/hoa/ | Mechanisch
IBL Sägeservice | Fe- & Nicht-Fe-Metalle, Zuschnitt | JA | https://shop.ibl-raimund.de/ | Mechanisch
Köllensperger | Stahl, Zuschnitt | JA | https://www.koellensperger-stahl.at/ | Mechanisch
Kugellager Express | Kugellager | NEIN | https://www.kugellager-express.de/ | Mechanisch | günstig, aber qualitativ schlechter
maunsystem | item-Profile & Verbinder, Kunststoffplatten, etc. | JA | https://www.maunsystem.de/ | Mechanisch
Metall Fachhandel | Nicht-Fe-Metalle, Zuschnitt | JA | https://metall-fachhandel.de/ | Mechanisch
Metzler | Werkzeug, Betriebsausstattung, etc. | JA | https://www.metzler.at/ | Mechanisch | Preise nur mit MCI Account sichtbar
Misumi | Maschinenelemente, Normteile, etc. | NEIN | https://de.misumi-ec.com | Mechanisch
Mouser | Elektrokomponenten | NEIN | https://www.mouser.at/ | Elektrisch
norelem | Maschinenelemente, Normteile, etc. | JA | https://norelem.de/de/ | Mechanisch
Obi | Baumarkt | NEIN | https://www.obi.at/ | Mechanisch | Bar bezahlen & Spesenabrechnung
Panta-Shop | Kugellager | JA | https://www.kugellager-panta.de/home-vm | Mechanisch
Plexcom | Plexiglas/PMMA | JA | https://www.plexcom.at/ | Mechanisch
Pointner Metallverarbeitung | Laserteile | JA | https://www.pointner.cc/# | Mechanisch | Schwaz
Ragg | Stahl, Zuschnitt | JA | https://www.ragg-stahlhandel.com/ | Mechanisch
Reichelt | Elektrokomponenten | NEIN | https://www.reichelt.at/ | Elektrisch
Robotshop | Elektrokomponenten | NEIN | https://eu.robotshop.com/de | Elektrisch
RS Components | Elektro- & Mechanische Komponenten | NEIN | https://at.rs-online.com/web/ | Diverses | Vielfach Zustellung am nächsten/übernächsten Tag
Schrauben TB | Schrauben | JA | https://shop.schrauben-tb.at/ | Mechanisch
SMT | item-Profile & Verbinder | JA | https://www.smt-montagetechnik.de/produkte/ | Mechanisch | selbe Firma wie Alcom
S-Polytec | Kunststoffplatten | JA | https://www.s-polytec.de/ | Mechanisch
Stasto | Pneumatik & Hydraulik Zubehör | JA | https://www.stasto.eu/ | Mechanisch
Top Maschinen | Maschinen | JA | https://www.top-maschinen.de/ | Mechanisch
WDS Components | Maschinenelemente, Normteile, etc. | JA | https://www.wdscomponents.com/de | Mechanisch | aus UK
Werkzeugprofi Köchl | Fräs-/Drehwerkzeuge | JA | https://www.werkzeug-profi.at/ | Mechanisch | in Birgitz
Würth | Betriebsaustattung, Maschinenelemente, etc. | NEIN | https://eshop.wuerth.at/de/DE/EUR/ | Mechanisch | Mutter aus Onlineshop, Tochter über Angebot

Sheet: Beispiel
Best. | Gegenstand | Händler | Artikelnummer | Link | Anzahl | Länge in m | Brutto pro VE | Netto pro VE | Brutto ges. | Netto ges. | kg/m | Masse in kg | Notiz
RFM | Pt100 4-Leiter | Conrad | 1579097 - 62 | https://www.conrad.at/de/p/sontec-tt6-045-a-a-4l-s-2-0-ade-pt100-temperaturfuehler-40-bis-180-c-1579097.html (https://www.haberkorn.com/item-profilsysteme/mb-systembaukasten/profile-und-zubehoer/konstruktionsprofil/1093819-konstruktionsprofil-8-rastermass-40-mm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) | 2 |  | 23.99 € | 19.99 € | 47.98 € | 39.98 €
RFM | Cuttermesser | Conrad | 1339848 - 62 | https://www.conrad.at/de/p/cuttermesser-c-k-t0951-1-st-1339848.html (https://www.haberkorn.com/item-profilsysteme/mb-systembaukasten/profile-und-zubehoer/konstruktionsprofil/1093819-konstruktionsprofil-8-rastermass-40-mm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) | 1 |  | 4.49 € | 3.74 € | 4.49 € | 3.74 €
MÄW | Aluprofil 8 80x40 schwer | Haberkorn | Z12685 | https://www.haberkorn.com/item-profilsysteme/mb-systembaukasten/profile-und-zubehoer/konstruktionsprofil/1093819-konstruktionsprofil-8-rastermass-40-mm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 | 2 | 1.75 | 58.90 € | 49.08 € | 206.14 € | 171.78 € | 4.53 | 15.86
MÄW | Aluprofil 8 80x40 schwer | Haberkorn | Z12685 | https://www.haberkorn.com/item-profilsysteme/mb-systembaukasten/profile-und-zubehoer/konstruktionsprofil/1093819-konstruktionsprofil-8-rastermass-40-mm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 | 3 | 0.8 | 58.90 € | 49.08 € | 141.35 € | 117.79 € | 4.53 | 10.87
BFD | Cap 0603 10V 3900p | Mouser | 581-06035C392K | https://mou.sr/3H4Pt14 | 50 |  | 0.06 € | 0.05 € | 2.80 € | 2.33 € |  |  | 1 Stk pro PCB
 |  |  |  |  |  |  |  |  | 402.75 € | 335.63 € |  | 26.7 kg | Summe

Sheet: Beschreibung-Spalten
Spalte | Name | Beschreibung
1 | Best. | Kürzel des Projektes für das die Bestellung getätigt wird. z.B.: SDL für allgemeines für das Labor, etc.
2 | Gegenstand | Beschreibung des Produktes
3 | Händler | Name des Händlers
4 | Artikelnummer | genaue Artikelnummer des Produktes beim ausgewählten Händler
5 | Link | Direkter Link zum Produkt auf der Homepage des Händlers
6 | Anzahl | Anzahl an Verkaufseinheiten (VE) die bezogen werden sollen
7 | Länge in m | Bei Zuschnittsware Länge in m pro Stk.
8 | Brutto pro VE | Bruttopreis pro VE --> wenn in dieser Spalte ein Wert eingetragen wird, so berechnet sich automatisch der Nettopreis pro VE
9 | Netto pro VE | Nettopreis pro VE --> wenn in dieser Spalte ein Wert eingetragen wird, so berechnet sich automatisch der Bruttopreis pro VE
10 | Brutto ges. | Gesamtbruttopreis berechnet aus Anzahl/Länge und Brutto pro VE
11 | Netto ges. | Gesamtnettopreis berechnet aus Gesamtbruttopreis
12 | kg/m | Hilfsspalte für Zuschnitte um Gesamtmasse zu berechnen
13 | Masse in kg | Hilfsspalte für Masse in kg Hilfreich um Versandkosten o.Ä. überschlagen zu können
14 | Notiz | Notiz
