Stefmci/ELEK_Inv_Pen/Komponenten und Auslegung/Zukaufteile_Bestellliste.xlsx

 | Zukaufteile:
Type | Artikel | Menge | Einheit | ungefähre Kosten | Produktlink
Gehäuse | Plexiglas 5mm Dicke | 0.134 | m² | €0.00
Gehäuse | Aluminiumprofil 20x20mm | 4.32 | m | €0.00
Rad | KAVAN SuperLight Scale Rad 100mm mit Kugellager | 2 | Stk. | €40.00 | https://www.lindinger.at/de/Flugzeuge/Flugzeug-Zubehoer/Raeder/KAVAN-SuperLight-Scale-Rad-100mm-mit-Kugellager-1-Stueck/13201
Motor | 12V DC-Getriebemotor mit Encoder 90:1 38kgcm | 2 | Stk. | €60.00 | https://www.dfrobot.com/product-1210.html
Motordriver | 2x7A DC Motor Driver | 1 | Stk. | €20.00 | https://www.dfrobot.com/product-1534.html
Akku | Makita Akku BL1840B 18V/4Ah Li-Ion | 1 | Stk. | €80.00 | https://www.makita.at/product/bl1840b.html
DC/DC-Wandler | Bauer Electronics DC-DC 18V-36V zu 12V Spannungs-Wandler 10A 120W | 1 | Stk. | €20.00 | https://www.amazon.de/Bauer-Electronics-12V-Spannungswandler-120W/dp/B09CYYTRTV?__mk_de_DE=ÅMÅŽÕÑ&sp_csd=d2lkZ2V0TmFtZT1zcF9hdGY
ESP01 | ESP8266 ESP-01S WiFi Modul | 1 | Stk. | €2.75 | ESP8266 ESP-01S WiFi Modul | Roboter-Bausatz.de (https://www.roboter-bausatz.de/p/ai-thinker-esp8266-esp-01s-wifi-modul)
Akkuadapter | 2 Pack QUPERR Power Wheel Adapter mit Sicherung & Schalter, Akku-Adapter für Makita 18V Lithium-Akku | 1 | Stk. | €18.00 | https://www.amazon.de/QUPERR-Sicherung-Akku-Adapter-Lithium-Akku-Power-Converter/dp/B0BPRYRGVF?__mk_de_DE=ÅMÅŽÕÑ
 |  |  |  | €240.75
