Stefmci/ELEK_Inv_Pen/Komponenten und Auslegung/PCB_Komponenten_Bestellliste.xlsm

Sheet: Bestellliste
Best. | Gegenstand | Händler | Artikelnummer | Link | Anzahl | Länge in m | Brutto pro VE | Netto pro VE | Brutto ges. | Netto ges. | kg/m | Masse in kg | Notiz
 | STM32H7A3RIT6 | Mouser | 511-STM32H7A3RIT6 | https://www.mouser.at/ProductDetail/STMicroelectronics/STM32H7A3RIT6?qs=xZ%2FP%252Ba9zWqZAEQXxnLVEdg%3D%3D | 1 |  | 14.50 € | 12.08 € | 14.50 € | 12.08 €
 | FT2232HL-Reel | Mouser | 895-FT2232HL | https://www.mouser.at/ProductDetail/FTDI/FT2232HL-REEL?qs=D1%2FPMqvA100v7FHcEx164g%3D%3D | 1 |  | 5.04 € | 4.20 € | 5.04 € | 4.20 €
 | ESP8266EX | Mouser | 356-ESP8266EX | https://www.mouser.at/ProductDetail/Espressif-Systems/ESP8266EX?qs=chTDxNqvsynorwcu2ADV3g%3D%3D | 1 |  | 1.52 € | 1.27 € | 1.52 € | 1.27 €
 | SN74LVC14AD | Mouser | 595-SN74LVC14AD | https://www.mouser.at/ProductDetail/Texas-Instruments/SN74LVC14AD?qs=L5CvrNUdZirGourz5jQzSQ%3D%3D | 1 |  | 0.87 € | 0.73 € | 0.87 € | 0.73 €
 | 93LC56BT-I/OT | Farnell | 1556165 | https://at.farnell.com/microchip/93lc56bt-i-ot/serial-eeprom-2kbit-2mhz-sot-23/dp/1556165?CMP=GRHB-OCTOPART | 1 |  | 14.77 € | 12.31 € | 14.77 € | 12.31 €
 | TPS2113APW | Mouser | 595-TPS2113APW | https://www.mouser.at/ProductDetail/Texas-Instruments/TPS2113APW?qs=ojKcPFmCWSUN5VlYBAYL8g%3D%3D | 1 |  | 2.60 € | 2.17 € | 2.60 € | 2.17 €
 | TS5A23157DGSR | Mouser | 595-TS5A23157DGSR | https://www.mouser.at/ProductDetail/Texas-Instruments/TS5A23157DGSR?qs=0O%2FZFlpUpJX9eVefTbxh%2FA%3D%3D | 1 |  | 0.45 € | 0.37 € | 0.45 € | 0.37 €
 | TPD2EUSB30DRTR | Mouser | 595-TPD2EUSB30DRTR | https://www.mouser.at/ProductDetail/Texas-Instruments/TPD2EUSB30DRTR?qs=%2Fqzd9s%252BcLd6bPJi5HXCDvw%3D%3D | 2 |  | 0.54 € | 0.45 € | 1.08 € | 0.90 €
 | LSM6DSOXTR | Mouser | 511-LSM6DSOXTR | https://www.mouser.at/ProductDetail/STMicroelectronics/LSM6DSOXTR?qs=l7cgNqFNU1i9dcjzItLpVQ%3D%3D | 2 |  | 4.01 € | 3.34 € | 8.02 € | 6.68 €
 | TSR 1-2433 | Mouser | 495-TSR-1-2433 | https://www.mouser.at/ProductDetail/TRACO-Power/TSR-1-2433?qs=ckJk83FOD0Wr1ojFRJK1OQ%3D%3D | 1 |  | 5.28 € | 4.40 € | 5.28 € | 4.40 €
 | TSR 1-2450 | Mouser | 495-TSR-1-2450 | https://www.mouser.at/ProductDetail/TRACO-Power/TSR-1-2450?qs=ckJk83FOD0XFKqda0Mzkgw%3D%3D | 1 |  | 5.28 € | 4.40 € | 5.28 € | 4.40 €
 | TSRN 1-2433SM | Farnell | 2414160 | https://at.farnell.com/traco-power/tsrn-1-2433sm/dc-dc-wandler-3-3v-1a/dp/2414160?CMP=GRHB-OCTOPART | 1 |  | 0.39 € | 0.32 € | 0.39 € | 0.32 €
 | SML-LX0404SIUPGUSB | Mouser | 696-LX0404SIUPGUSB | https://www.mouser.at/ProductDetail/696-LX0404SIUPGUSB | 1 |  | 0.77 € | 0.64 € | 0.77 € | 0.64 €
 | SML-LXT0805IW-TR | Mouser | 696-SML-LXT0805IW | https://www.mouser.at/ProductDetail/696-SML-LXT0805IW | 2 |  | 0.20 € | 0.17 € | 0.40 € | 0.33 €
 | SML-LXT0805GW-TR | Mouser | 696-SML-LXT0805GW | https://www.mouser.at/ProductDetail/696-SML-LXT0805GW | 2 |  | 0.26 € | 0.21 € | 0.51 € | 0.43 €
 | HZ0805E601R-10 | Mouser | 875-HZ0805E601R-10 | https://www.mouser.at/ProductDetail/875-HZ0805E601R-10 | 2 |  | 0.11 € | 0.09 € | 0.23 € | 0.19 €
 | ABM8AIG-24.000MHZ-12-2Z-T3 | Mouser | 815-M8AIG-24-12-2ZT3 | https://www.mouser.at/ProductDetail/ABRACON/ABM8AIG-24.000MHZ-12-2Z-T3?qs=gG6m684uYP5orUQEAtjKng%3D%3D | 1 |  | 1.26 € | 1.05 € | 1.26 € | 1.05 €
 | ABLS2-12.000MHZ-B4Y-T | Mouser | 815-ABLS2-12-B4YT | https://www.mouser.at/ProductDetail/ABRACON/ABLS2-12.000MHZ-B4Y-T?qs=DZ%2FvJMgWWIs6Scm%252BixQ6gw%3D%3D | 1 |  | 0.30 € | 0.25 € | 0.30 € | 0.25 €
 | ABM8-26.000MHZ-10-1-U-T | Mouser | 815-ABM8-26-T | https://www.mouser.at/ProductDetail/ABRACON/ABM8-26.000MHZ-10-1-U-T?qs=76dmnhCH%2FMP1JRP6EvWbSw%3D%3D | 1 |  | 0.91 € | 0.76 € | 0.91 € | 0.76 €
 | PCM12SMTR | Mouser | 611-PCM12SMTR | https://www.mouser.at/ProductDetail/CK/PCM12SMTR?qs=mfFuHy8STfL3qrPSfCHA7w%3D%3D | 2 |  | 1.08 € | 0.90 € | 2.16 € | 1.80 €
 | PTS645SM43SMTR92LFS | Mouser | 611-PTS645SM43SMTR92 | https://www.mouser.at/ProductDetail/CK/PTS645SM43SMTR92-LFS?qs=Imq1NPwxi75hrUk5xRQGSg%3D%3D | 4 |  | 0.26 € | 0.21 € | 1.03 € | 0.86 €
 | 691210910004 | Mouser | 710-691210910004 | https://www.mouser.at/ProductDetail/Wurth-Elektronik/691210910004?qs=sPbYRqrBIVlxffWXw70IkA%3D%3D | 2 |  | 1.67 € | 1.39 € | 3.34 € | 2.78 €
 | 691214110002 | Mouser | 710-691214110002 | https://www.mouser.at/ProductDetail/Wurth-Elektronik/691214110002?qs=7gQLVZk5cPmb9EqUyfv%252B2g%3D%3D | 5 |  | 0.75 € | 0.63 € | 3.75 € | 3.13 €
 | 213083-0005 | Mouser | 538-213083-0005 | https://www.mouser.at/ProductDetail/Molex/213083-0005?qs=IS%252B4QmGtzzp3iDJcXWaSTg%3D%3D | 1 |  | 3.77 € | 3.14 € | 3.77 € | 3.14 €
 | 61300211121 | Mouser | 710-61300211121 | https://www.mouser.at/ProductDetail/Wurth-Elektronik/61300211121?qs=t4813l51qx%252B1A5GYDQxPlw%3D%3D | 10 |  | 0.10 € | 0.08 € | 0.97 € | 0.81 €
 | 61301021121 | Mouser | 710-61301021121 | https://www.mouser.at/ProductDetail/Wurth-Elektronik/61301021121?qs=ZtY9WdtwX5612K9FdDCZCA%3D%3D | 5 |  | 0.95 € | 0.79 € | 4.75 € | 3.96 €
 | BSS138 | Mouser | 512-BSS138 | https://www.mouser.at/ProductDetail/onsemi-Fairchild/BSS138?qs=HK%252BeIG1iaahCeqBvjB4arg%3D%3D | 4 |  | 0.26 € | 0.21 € | 1.03 € | 0.86 €
 | LQW18AN4N3C00D | Mouser | 81-LQW18AN4N3C00D | https://www.mouser.at/ProductDetail/Murata-Electronics/LQW18AN4N3C00D?qs=W2MaHu96STZjVSBQr%252BDZxQ%3D%3D | 1 |  | 0.11 € | 0.09 € | 0.11 € | 0.10 €
 | 7447840015G | Mouser | 710-7447840015G | https://www.mouser.at/ProductDetail/Wurth-Elektronik/7447840015G?qs=aP1CjGhiNiHkJAv%2FaOK7Aw%3D%3D | 1 |  | 0.10 € | 0.08 € | 0.10 € | 0.08 €
 | W25Q32FV | Mouser | 474-COM-15809 | COM-15809 SparkFun | Mouser Austria (https://www.mouser.at/ProductDetail/SparkFun/COM-15809?qs=wnTfsH77Xs4W6lzhkB8rzg%3D%3D) | 1 |  | 1.86 € | 1.55 € | 1.86 € | 1.55 €
 | EEEFT1H221AP | Mouser | 667-EEE-FT1H221AP | https://www.mouser.at/ProductDetail/Panasonic/EEE-FT1H221AP?qs=CMJjuEs1%252BuFFGBuxQbDfDA%3D%3D | 1 |  | 1.02 € | 0.85 € | 1.02 € | 0.85 € |  |  | 220µF 50V Aluminium ELCO
 | EEEFK1H101P | Mouser | 667-EEE-FK1H101P | https://www.mouser.at/ProductDetail/Panasonic/EEE-FK1H101P?qs=qE6bgDGEOCvpdTqIVQNh4Q%3D%3D | 1 |  | 0.70 € | 0.59 € | 0.70 € | 0.59 € |  |  | 100µF 50V Aluminium ELCO
 | EEEFT1H470AP | Mouser | 667-EEE-FT1H470AP | https://www.mouser.at/ProductDetail/Panasonic/EEE-FT1H470AP?qs=CMJjuEs1%252BuGwCsNIEusjpA%3D%3D | 3 |  | 0.61 € | 0.51 € | 1.82 € | 1.52 € |  |  | 47µF 50V Aluminium ELCO
 | EEE-FC1H220P | Mouser | 667-EEE-FC1H220P | https://www.mouser.at/ProductDetail/Panasonic/EEE-FC1H220P?qs=wEytwf7f49E5aS6lw2N%2FpQ%3D%3D | 1 |  | 0.52 € | 0.44 € | 0.52 € | 0.44 € |  |  | 22µF 50V Aluminium ELCO
 | EEE-FK1H100UR | Mouser | 667-EEE-FK1H100UR | https://www.mouser.at/ProductDetail/Panasonic/EEE-FK1H100UR?qs=qE6bgDGEOCsEuFChZPEPmw%3D%3D | 1 |  | 0.31 € | 0.26 € | 0.31 € | 0.26 € |  |  | 10µF 50V Aluminium ELCO
 | C0603C829C5GACTU | Mouser | 80-C0603C829C5G | https://www.mouser.at/ProductDetail/KEMET/C0603C829C5GACTU?qs=I3JbKodHcjiKB1jPZKr7Dw%3D%3D | 1 |  | 0.14 € | 0.12 € | 0.14 € | 0.12 € |  |  | KerKo 8.2pF 50V 0603
 | CBR04C249B5GAC | Mouser | 80-CBR04C249B5G | https://www.mouser.at/ProductDetail/KEMET/CBR04C249B5GAC?qs=XxWtqqdu%2F9GpYW2wwEqspw%3D%3D | 1 |  | 0.13 € | 0.11 € | 0.13 € | 0.11 € |  |  | KerKo 2.4pF 50V 0402
 | GRM21BR61H106KE43L | Mouser | 81-GRM21BR61H106KE3L | https://www.mouser.at/ProductDetail/Murata-Electronics/GRM21BR61H106KE43L?qs=lYGu3FyN48cBZlIduWKclg%3D%3D | 2 |  | 0.27 € | 0.22 € | 0.53 € | 0.44 € |  |  | KerKo 10µF 50V 0805
 | C2012X5R1H475K125AB | Mouser | 810-C2012X5R1H475K | https://www.mouser.at/ProductDetail/TDK/C2012X5R1H475K125AB?qs=NRhsANhppD%252BC04rCIKmBpA%3D%3D | 3 |  | 0.45 € | 0.37 € | 1.34 € | 1.12 € |  |  | KerKo 4.7µF 50V 0805
 | CGA4J3X7R1H225K125AE | Mouser | 810-CGA4J3X7R1H225KE | https://www.mouser.at/ProductDetail/TDK/CGA4J3X7R1H225K125AE?qs=P%2FC4Eoq9CDwFRkh%2Fc8nt%2FA%3D%3D | 2 |  | 0.53 € | 0.44 € | 1.06 € | 0.89 € |  |  | KerKo 2.2µF 50V 0805
 | C0805C105K5RACTU | Mouser | 80-C0805C105K5R | https://www.mouser.at/ProductDetail/KEMET/C0805C105K5RACTU?qs=iP0bYSAMAFrBrUflcErrLQ%3D%3D | 2 |  | 0.29 € | 0.25 € | 0.59 € | 0.49 € |  |  | KerKo 1µF 50V 0805
 | C0805C270J5GACTU | Mouser | 80-C0805C270J5G | https://www.mouser.at/ProductDetail/KEMET/C0805C270J5GACTU?qs=PkXL6o6vp1EdbKoO6h1EFg%3D%3D | 2 |  | 0.10 € | 0.08 € | 0.19 € | 0.16 € |  |  | KerKo 27pF 50V 0805
 | 08055A150JAT2A | Mouser | 581-08055A150J | https://www.mouser.at/ProductDetail/KYOCERA-AVX/08055A150JAT2A?qs=pZVDklL%2Fs8hiEua37sqbaA%3D%3D | 2 |  | 0.10 € | 0.08 € | 0.19 € | 0.16 € |  |  | KerKo 15pF 50V 0805
 | 08055A100JAT2A | Mouser | 581-08055A100J | https://www.mouser.at/ProductDetail/KYOCERA-AVX/08055A100JAT2A?qs=sXYjIdLHthxdnSWJ4UNpVw%3D%3D | 2 |  | 0.10 € | 0.08 € | 0.19 € | 0.16 € |  |  | KerKo 10pF 50V 0805
 | TNPW0805499RBEEN | Mouser | 71-TNPW0805499RBEEN | https://www.mouser.at/ProductDetail/Vishay/TNPW0805499RBEEN?qs=mM8c4%252BCQc9U969g4vMYprA%3D%3D | 2 |  | 0.42 € | 0.35 € | 0.84 € | 0.70 € |  |  | Widerstand 499 Ohm 0805 (nicht in E12-Reihe)
 | CRCW0805200RFKEA | Mouser | 71-CRCW0805-200-E3 | https://www.mouser.at/ProductDetail/Vishay/CRCW0805200RFKEA?qs=t6Mf8e9K%2Funa9GclCWxh6A%3D%3D | 1 |  | 0.10 € | 0.08 € | 0.10 € | 0.08 € |  |  | Widerstand 200 Ohm 0805 (nicht in E12-Reihe)
 | ERJ-6ENF24R9V | Mouser | 667-ERJ-6ENF24R9V | https://www.mouser.at/ProductDetail/Panasonic/ERJ-6ENF24R9V?qs=50QC8w71jAuHKLC%252Bezoy5Q%3D%3D | 1 |  | 0.10 € | 0.09 € | 0.10 € | 0.09 € |  |  | Widerstand 24.9 Ohm 0805 (nicht in E12-Reihe)
 | CRCW08054K30FKEA | Mouser | 71-CRCW08054K30FKEA | https://www.mouser.at/ProductDetail/Vishay/CRCW08054K30FKEA?qs=kkyyugUlSrOMwrmfKiw%252BeQ%3D%3D | 1 |  | 0.10 € | 0.08 € | 0.10 € | 0.08 € |  |  | Widerstand 4.3k Ohm 0805 (nicht in E12-Reihe)
 | RN73C2A5K11BTDF | Mouser | 279-RN73CA-5.11K | https://www.mouser.at/ProductDetail/TE-Connectivity-Holsworthy/RN73C2A5K11BTDF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 | 2 |  | 0.98 € | 0.82 € | 1.96 € | 1.63 € |  |  | Widerstand 5.11k Ohm 0805 (nicht in E12-Reihe)
 | RC0805JR-072KL | Mouser | 603-RC0805JR-072KL | https://www.mouser.at/ProductDetail/YAGEO/RC0805JR-072KL?qs=KyGMWp10UkspCtNMkbcovQ%3D%3D | 1 |  | 0.10 € | 0.08 € | 0.10 € | 0.08 € |  |  | Widerstand 2k Ohm 0805 (nicht in E12-Reihe)
 | RC0805JR-070RL | Mouser | 603-RC0805JR-070RL | https://www.mouser.at/ProductDetail/YAGEO/RC0805JR-070RL?qs=3ldFlDWnkKyEhdaPjQHEFA%3D%3D | 4 |  | 0.10 € | 0.08 € | 0.38 € | 0.32 € |  |  | Widerstand 0 Ohm 0805 (nicht in E12-Reihe)
 |  |  |  |  |  |  |  |  | 99.38 € | 82.82 € |  | 0.0 kg | Summe

Sheet: Übliche Händler
Händler | Beschreibung | Angebot notwendig? | Link | Kategorie | Notiz
Alcom | item-Profile & Verbinder | JA | https://www.alcom-international.de/baukastensystem.html | Mechanisch | selbe Firma wie SMT
Amazon | Diverses | NEIN | https://amazon.de | Diverses | Bestellung nur möglich, wenn Händler eine ordentliche Rechnung stellen kann
Bauhaus | Baumarkt | NEIN | https://www.bauhaus.at/ | Mechanisch | Bar bezahlen & Spesenabrechnung
CNCShop | CNC-Komponenten | JA | https://www.cncshop.at/ | Mechanisch
Conrad | Elektrokomponenten | NEIN | https://www.conrad.at/ | Elektrisch
Contorion | Werkzeug, Betriebsausstattung, etc. | NEIN | https://www.contorion.at/ | Mechanisch
Digikey | Elektrokomponenten | NEIN | https://www.digikey.at/ | Elektrisch
Distrelec | Elektrokomponenten | NEIN | https://www.distrelec.at/ | Elektrisch
DOLD Mechatronik | item-Profile, Motoren, etc. | JA | https://www.dold-mechatronik.de/ | Diverses
Eckstein Komponenten | Elektrokomponenten | JA | https://eckstein-shop.de/Startseite | Elektrisch
Elesa+Ganter | Maschinenelemente, Normteile, etc. | NEIN | https://www.elesa-ganter.at/de/aut | Mechanisch
ELV Elektronik | Elektrokomponenten | JA | https://de.elv.com/ | Elektrisch
Eurocircuits | PCBs & Bestückung | NEIN | https://www.eurocircuits.com/ | Elektrisch
faigle Kunststoffe | Plexiglas/PMMA | JA | https://www.faigle.com/en | Mechanisch
Fix Metall | Fe- & Nicht-Fe-Metalle, Zuschnitt | NEIN | https://www.fixmetall-shop.com/ | Mechanisch
Funkenflug | Laserteile | JA | https://www.funkenflug.co.at/ | Mechanisch | in Kematen
Gemmel Metalle | Fe- & Nicht-Fe-Metalle, Zuschnitt | JA | https://www.gemmel-metalle.de/ | Mechanisch | gezogene Al-Wellen
Haberkorn | Maschinenelemente, item-Profile, etc. | NEIN | https://www.haberkorn.com/ | Mechanisch | Preise nur mit MCI Account sichtbar
Hoffmann | Werkzeug, Betriebsausstattung, etc. | NEIN | https://www.hoffmann-group.com/AT/de/hoa/ | Mechanisch
IBL Sägeservice | Fe- & Nicht-Fe-Metalle, Zuschnitt | JA | https://shop.ibl-raimund.de/ | Mechanisch
Köllensperger | Stahl, Zuschnitt | JA | https://www.koellensperger-stahl.at/ | Mechanisch
Kugellager Express | Kugellager | NEIN | https://www.kugellager-express.de/ | Mechanisch | günstig, aber qualitativ schlechter
maunsystem | item-Profile & Verbinder, Kunststoffplatten, etc. | JA | https://www.maunsystem.de/ | Mechanisch
Metall Fachhandel | Nicht-Fe-Metalle, Zuschnitt | JA | https://metall-fachhandel.de/ | Mechanisch
Metzler | Werkzeug, Betriebsausstattung, etc. | JA | https://www.metzler.at/ | Mechanisch | Preise nur mit MCI Account sichtbar
Misumi | Maschinenelemente, Normteile, etc. | NEIN | https://de.misumi-ec.com | Mechanisch
Mouser | Elektrokomponenten | NEIN | https://www.mouser.at/ | Elektrisch
norelem | Maschinenelemente, Normteile, etc. | JA | https://norelem.de/de/ | Mechanisch
Obi | Baumarkt | NEIN | https://www.obi.at/ | Mechanisch | Bar bezahlen & Spesenabrechnung
Panta-Shop | Kugellager | JA | https://www.kugellager-panta.de/home-vm | Mechanisch
Plexcom | Plexiglas/PMMA | JA | https://www.plexcom.at/ | Mechanisch
Pointner Metallverarbeitung | Laserteile | JA | https://www.pointner.cc/# | Mechanisch | Schwaz
Ragg | Stahl, Zuschnitt | JA | https://www.ragg-stahlhandel.com/ | Mechanisch
Reichelt | Elektrokomponenten | NEIN | https://www.reichelt.at/ | Elektrisch
Robotshop | Elektrokomponenten | NEIN | https://eu.robotshop.com/de | Elektrisch
RS Components | Elektro- & Mechanische Komponenten | NEIN | https://at.rs-online.com/web/ | Diverses | Vielfach Zustellung am nächsten/übernächsten Tag
Schrauben TB | Schrauben | JA | https://shop.schrauben-tb.at/ | Mechanisch
SMT | item-Profile & Verbinder | JA | https://www.smt-montagetechnik.de/produkte/ | Mechanisch | selbe Firma wie Alcom
S-Polytec | Kunststoffplatten | JA | https://www.s-polytec.de/ | Mechanisch
Stasto | Pneumatik & Hydraulik Zubehör | JA | https://www.stasto.eu/ | Mechanisch
Top Maschinen | Maschinen | JA | https://www.top-maschinen.de/ | Mechanisch
WDS Components | Maschinenelemente, Normteile, etc. | JA | https://www.wdscomponents.com/de | Mechanisch | aus UK
Werkzeugprofi Köchl | Fräs-/Drehwerkzeuge | JA | https://www.werkzeug-profi.at/ | Mechanisch | in Birgitz
Würth | Betriebsaustattung, Maschinenelemente, etc. | NEIN | https://eshop.wuerth.at/de/DE/EUR/ | Mechanisch | Mutter aus Onlineshop, Tochter über Angebot

Sheet: Beispiel
Best. | Gegenstand | Händler | Artikelnummer | Link | Anzahl | Länge in m | Brutto pro VE | Netto pro VE | Brutto ges. | Netto ges. | kg/m | Masse in kg | Notiz
RFM | Pt100 4-Leiter | Conrad | 1579097 - 62 | https://www.conrad.at/de/p/sontec-tt6-045-a-a-4l-s-2-0-ade-pt100-temperaturfuehler-40-bis-180-c-1579097.html (https://www.haberkorn.com/item-profilsysteme/mb-systembaukasten/profile-und-zubehoer/konstruktionsprofil/1093819-konstruktionsprofil-8-rastermass-40-mm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) | 2 |  | 23.99 € | 19.99 € | 47.98 € | 39.98 €
RFM | Cuttermesser | Conrad | 1339848 - 62 | https://www.conrad.at/de/p/cuttermesser-c-k-t0951-1-st-1339848.html (https://www.haberkorn.com/item-profilsysteme/mb-systembaukasten/profile-und-zubehoer/konstruktionsprofil/1093819-konstruktionsprofil-8-rastermass-40-mm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) | 1 |  | 4.49 € | 3.74 € | 4.49 € | 3.74 €
MÄW | Aluprofil 8 80x40 schwer | Haberkorn | Z12685 | https://www.haberkorn.com/item-profilsysteme/mb-systembaukasten/profile-und-zubehoer/konstruktionsprofil/1093819-konstruktionsprofil-8-rastermass-40-mm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 | 2 | 1.75 | 58.90 € | 49.08 € | 206.14 € | 171.78 € | 4.53 | 15.86
MÄW | Aluprofil 8 80x40 schwer | Haberkorn | Z12685 | https://www.haberkorn.com/item-profilsysteme/mb-systembaukasten/profile-und-zubehoer/konstruktionsprofil/1093819-konstruktionsprofil-8-rastermass-40-mm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 | 3 | 0.8 | 58.90 € | 49.08 € | 141.35 € | 117.79 € | 4.53 | 10.87
BFD | Cap 0603 10V 3900p | Mouser | 581-06035C392K | https://mou.sr/3H4Pt14 | 50 |  | 0.06 € | 0.05 € | 2.80 € | 2.33 € |  |  | 1 Stk pro PCB
 |  |  |  |  |  |  |  |  | 402.75 € | 335.63 € |  | 26.7 kg | Summe

Sheet: Beschreibung-Spalten
Spalte | Name | Beschreibung
1 | Best. | Kürzel des Projektes für das die Bestellung getätigt wird. z.B.: SDL für allgemeines für das Labor, etc.
2 | Gegenstand | Beschreibung des Produktes
3 | Händler | Name des Händlers
4 | Artikelnummer | genaue Artikelnummer des Produktes beim ausgewählten Händler
5 | Link | Direkter Link zum Produkt auf der Homepage des Händlers
6 | Anzahl | Anzahl an Verkaufseinheiten (VE) die bezogen werden sollen
7 | Länge in m | Bei Zuschnittsware Länge in m pro Stk.
8 | Brutto pro VE | Bruttopreis pro VE --> wenn in dieser Spalte ein Wert eingetragen wird, so berechnet sich automatisch der Nettopreis pro VE
9 | Netto pro VE | Nettopreis pro VE --> wenn in dieser Spalte ein Wert eingetragen wird, so berechnet sich automatisch der Bruttopreis pro VE
10 | Brutto ges. | Gesamtbruttopreis berechnet aus Anzahl/Länge und Brutto pro VE
11 | Netto ges. | Gesamtnettopreis berechnet aus Gesamtbruttopreis
12 | kg/m | Hilfsspalte für Zuschnitte um Gesamtmasse zu berechnen
13 | Masse in kg | Hilfsspalte für Masse in kg Hilfreich um Versandkosten o.Ä. überschlagen zu können
14 | Notiz | Notiz
