Stefmci/ELEK_Inv_Pen/02_Konstruktion/Gesamtbaugruppe.SLDASM

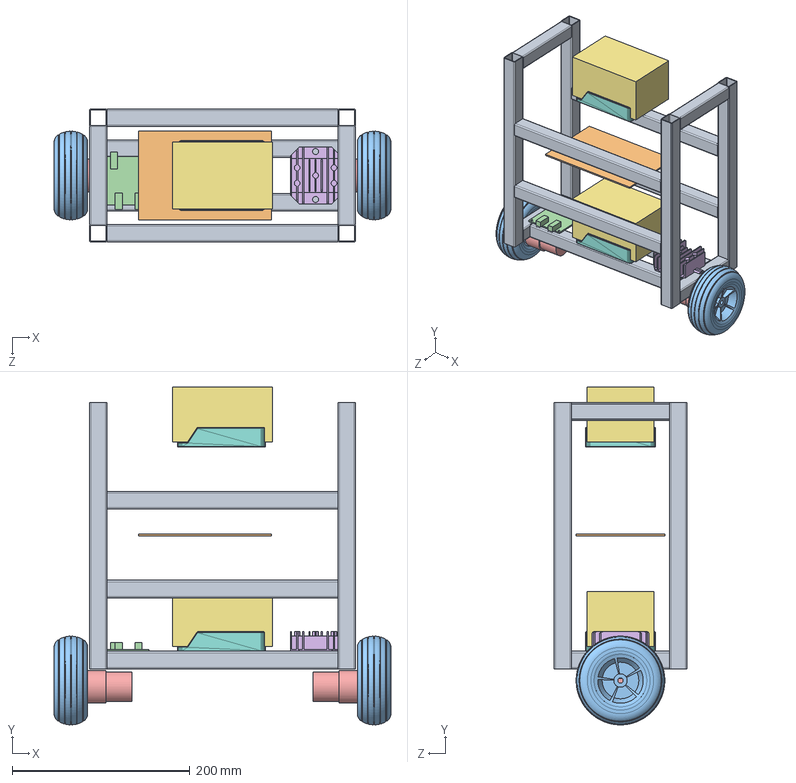
[picture p37: CAD file, 2025-06-03]
02_Konstruktion/Gesamtbaugruppe.SLDASM
379.6 x 380.5 x 150.0 mm
Akku_Aufnahme x 2
Akku x 2
DC-DC
Motor x 2
Motor_Driver
Reifen x 2
platine
Rahmen
