Stefmci/ELEK_Inv_Pen/02_Konstruktion/Akkubaugruppe.SLDASM

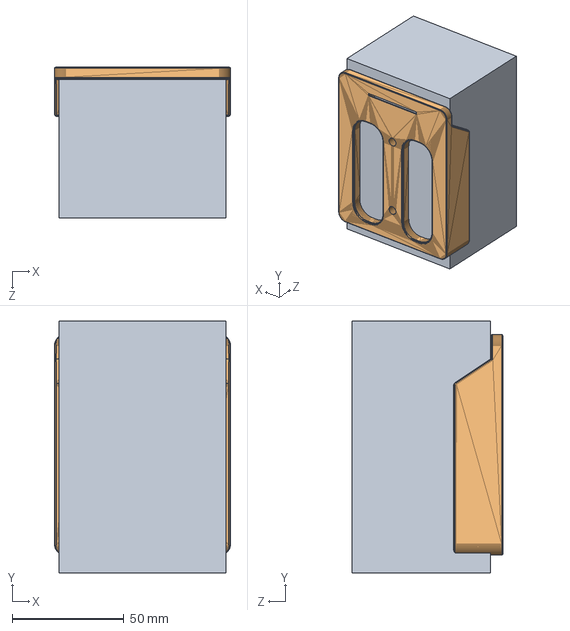
[picture p38: CAD file, 2025-06-03]
02_Konstruktion/Akkubaugruppe.SLDASM
79.0 x 113.0 x 67.5 mm
Akku_Aufnahme
Akku
