Stefmci/ELEK_Inv_Pen/LOGO_MCI.dxf

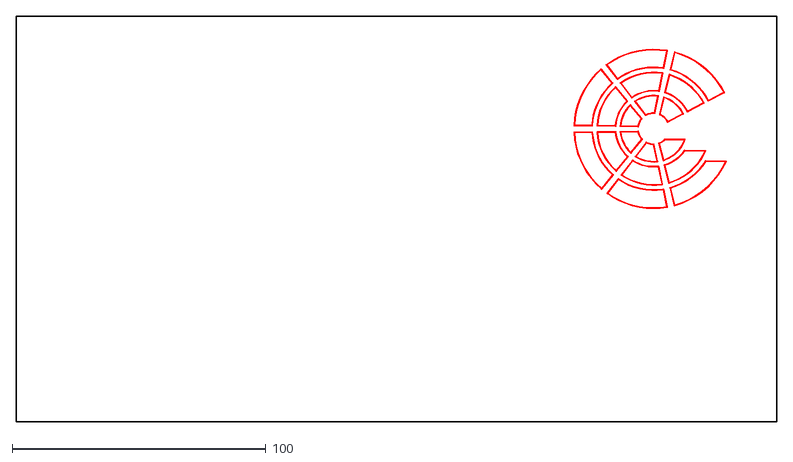
[picture p39: CAD file, 2025-06-03]
LOGO_MCI.dxf
300.0 x 160.0
