Stefmci/ELEK_Inv_Pen/02_Konstruktion/Verbinder.SLDPRT

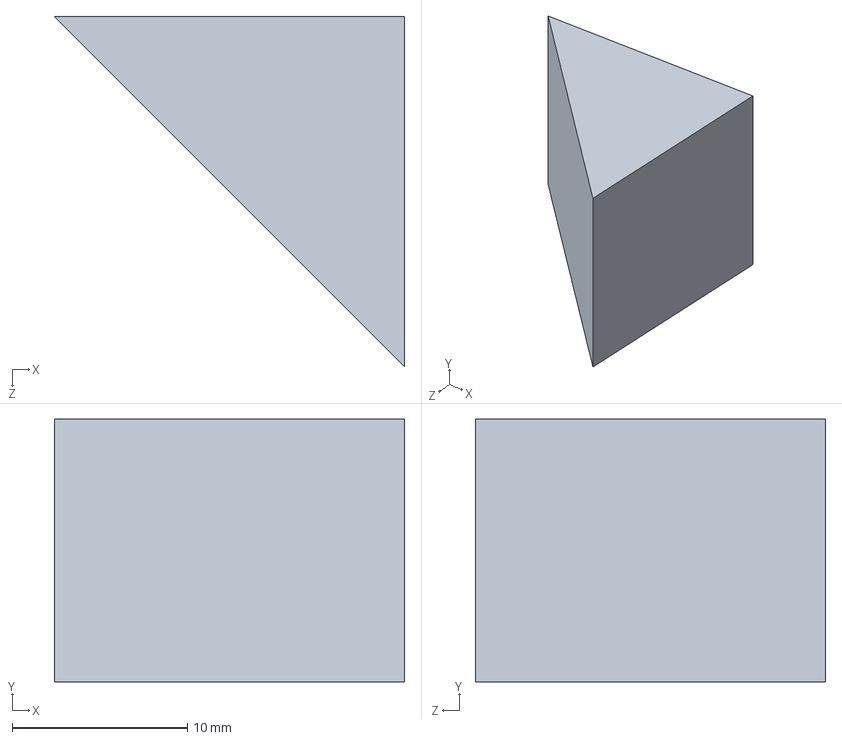
[picture p40: CAD file, 2025-06-09]
02_Konstruktion/Verbinder.SLDPRT
20.0 x 15.0 x 20.0 mm
