Stefmci/ELEK_Inv_Pen/02_Konstruktion/Akku_Aufnahme.SLDPRT

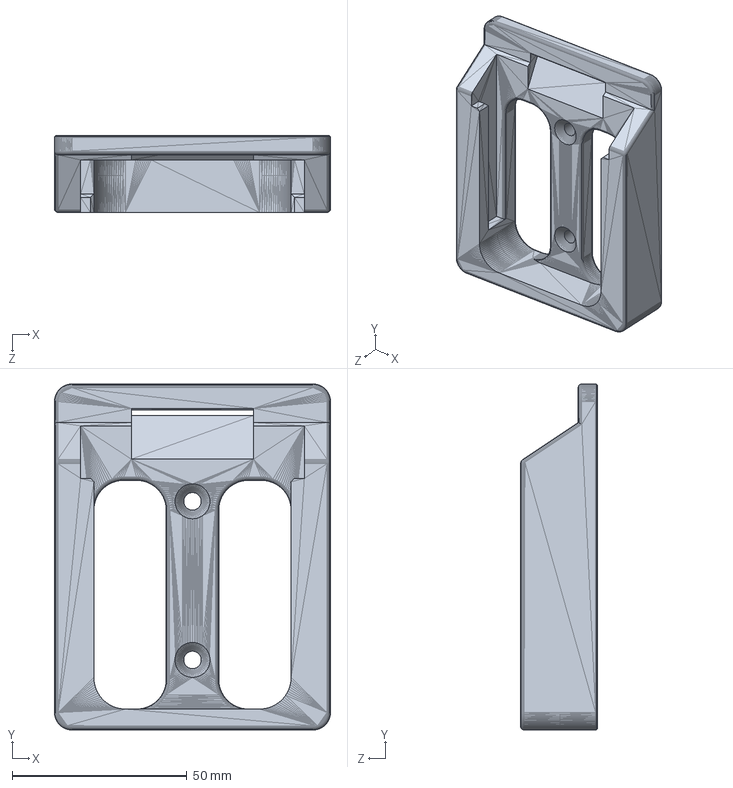
[picture p41: CAD file, 2025-06-03]
02_Konstruktion/Akku_Aufnahme.SLDPRT
79.0 x 99.0 x 22.0 mm
