Stefmci/ELEK_Inv_Pen/02_Konstruktion/Akku.SLDPRT

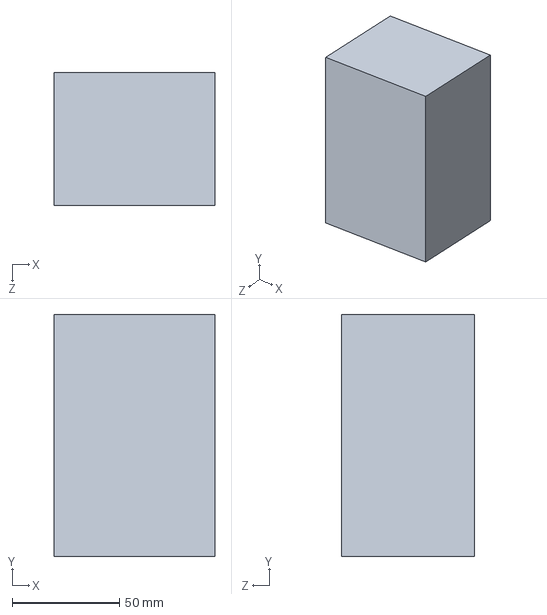
[picture p42: CAD file, 2025-06-03]
02_Konstruktion/Akku.SLDPRT
75.0 x 113.0 x 62.0 mm
