Stefmci/ELEK_Inv_Pen/02_Konstruktion/Reifen.SLDPRT

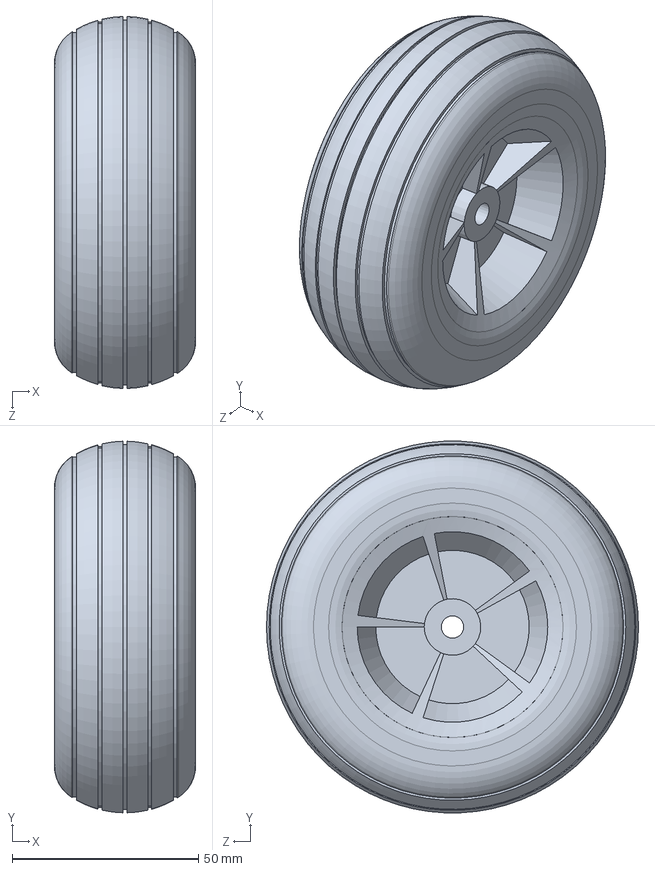
[picture p43: CAD file, 2025-06-03]
02_Konstruktion/Reifen.SLDPRT
38.0 x 99.9 x 100.0 mm
