Stefmci/ELEK_Inv_Pen/02_Konstruktion/Rahmen.SLDPRT

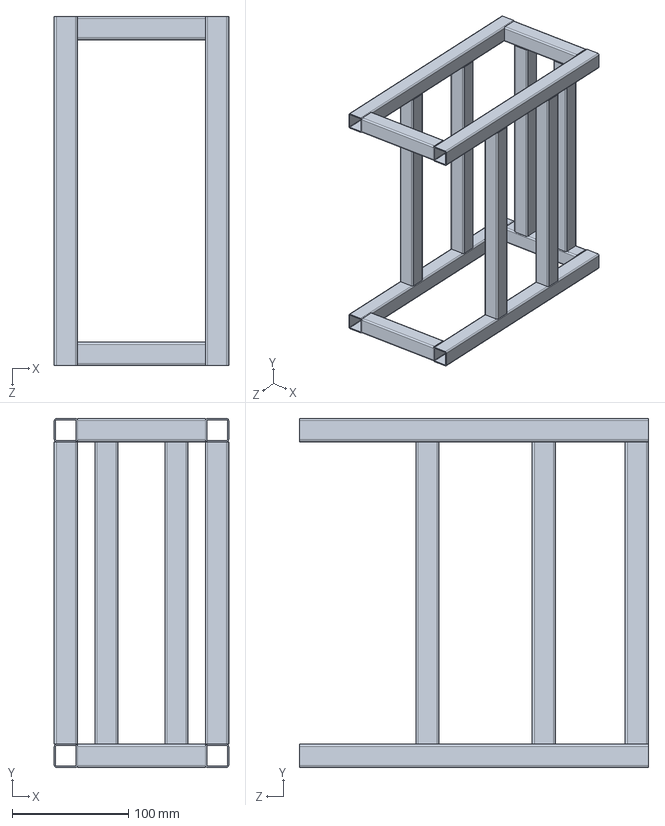
[picture p44: CAD file, 2025-06-03]
02_Konstruktion/Rahmen.SLDPRT
150.0 x 300.0 x 300.0 mm
