Stefmci/ELEK_Inv_Pen/02_Konstruktion/Motor.SLDPRT

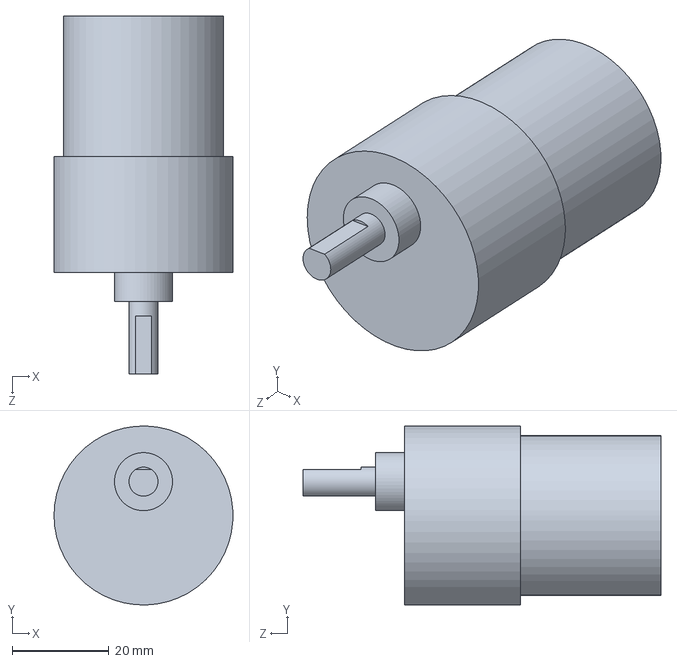
[picture p45: CAD file, 2025-06-03]
02_Konstruktion/Motor.SLDPRT
37.0 x 37.0 x 74.0 mm
