Stefmci/ELEK_Inv_Pen/02_Konstruktion/platine.SLDPRT

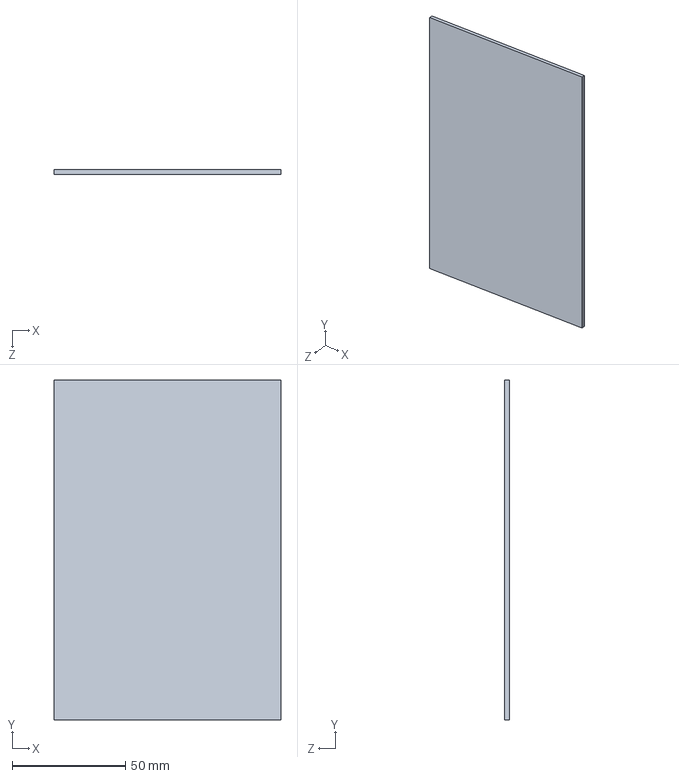
[picture p46: CAD file, 2025-06-03]
02_Konstruktion/platine.SLDPRT
100.0 x 150.0 x 2.00 mm
