Stefmci/ELEK_Inv_Pen/02_Konstruktion/DC-DC.SLDPRT

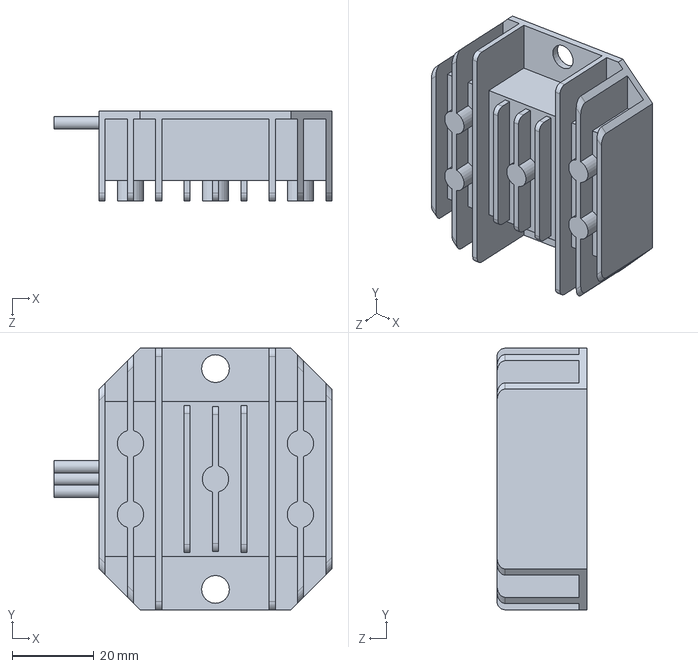
[picture p47: CAD file, 2025-06-03]
02_Konstruktion/DC-DC.SLDPRT
68.0 x 64.0 x 22.0 mm
