Stefmci/ELEK_Inv_Pen/02_Konstruktion/Motor_Driver.SLDPRT

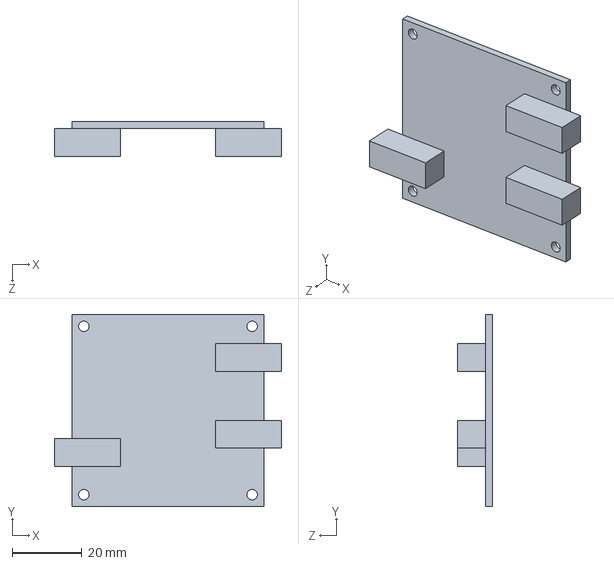
[picture p48: CAD file, 2025-06-03]
02_Konstruktion/Motor_Driver.SLDPRT
65.0 x 55.0 x 10.0 mm
