Stefmci/ELEK_Inv_Pen/02_Konstruktion/Modell_ELEK.SLDPRT

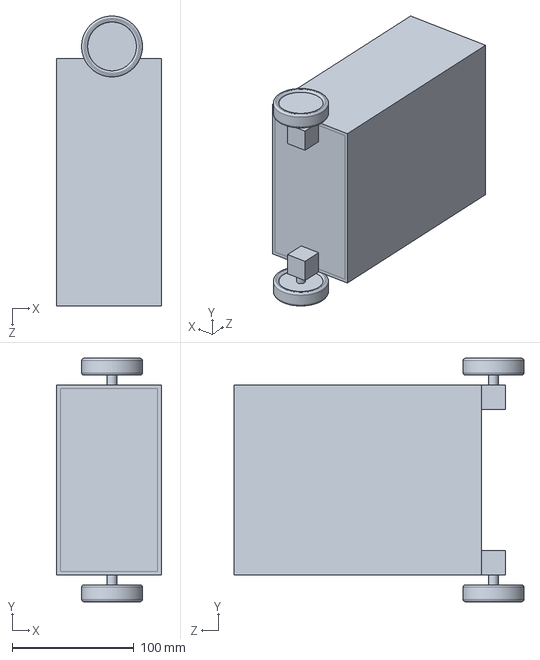
[picture p49: CAD file, 2025-05-18]
02_Konstruktion/Modell_ELEK.SLDPRT
86.0 x 200.0 x 238.0 mm
