Stefmci/ELEK_Inv_Pen/(list of files, cad)

Other CAD files:
02_Konstruktion/Aufprallpuffer.SLDPRT
02_Konstruktion/Plexiglas.SLDPRT
