Stefmci/ELEK_Inv_Pen/(list of files, drawings)

Other design files:
01_Vorlesung_Altium_Projekte/first_project.PrjPcb
01_Vorlesung_Altium_Projekte/PCB1.PcbDoc
01_Vorlesung_Altium_Projekte/Sheet1.SchDoc
03_Inv_Pen_PCB/ESP8266.PcbDoc
03_Inv_Pen_PCB/ESP8266.SchDoc
03_Inv_Pen_PCB/Inv_Pen_PCB.PrjPcb
03_Inv_Pen_PCB/stm32_schematic.SchDoc
03_Inv_Pen_PCB/Zusammenbau.SchDoc
merged_project/merged_project_old/ESP8266_final.SchDoc
merged_project/merged_project_old/PCB1.PcbDoc
merged_project/merged_project_old/PCB_USB_UART.SchDoc
merged_project/merged_project_old/stm32_schematic.SchDoc
merged_project/merged_project_very_old/ESP8266_final.SchDoc
merged_project/merged_project_very_old/merged_project.PrjPcb
merged_project/merged_project_very_old/PCB1.PcbDoc
merged_project/merged_project_very_old/PCB_USB_UART.SchDoc
merged_project/merged_project_very_old/stm32_schematic.SchDoc
PCB_Final_mit_Gerber/ESP8266_final.SchDoc
PCB_Final_mit_Gerber/merged_project.PrjPcb
PCB_Final_mit_Gerber/PCB1.PcbDoc
PCB_Final_mit_Gerber/PCB_USB_UART.SchDoc
PCB_Final_mit_Gerber/PcbLib1.PcbLib
PCB_Final_mit_Gerber/RF_ESP8266.SchLib
PCB_Final_mit_Gerber/stm32_schematic.SchDoc
UART_Schnittstelle/PCB_USB_UART.SchDoc
UART_Schnittstelle/UART_Schnittstelle.PrjPcb
