Stefmci/ELEK_Inv_Pen/(commit log)

2025-04-08 Daten aus Nextcloud hochgeladen
    [Inv_Pen_PCB.PrjPcb, Inv_Pen_Schaltplan.SchDoc, PCB1.PcbDoc, Sheet1.SchDoc, first_project.PrjPcb, kosten.ods]
2025-04-08 stm32 Datenblätter hinzug.
2025-04-08 Schaltpläne hinzugefügt
    [ESP8684H4.SchDoc, Inv_Pen_Schaltplan.SchDoc, STM32.SchDoc, UART.SchDoc, Zus.SchDoc]
2025-04-09 datenblatt ESP Dev board
2025-04-22 datablaetter stm32 h7
2025-05-06 Sheet stm32 uploaded
    [stm32_schematic.SchDoc]
2025-05-17 Wifi Modul grober Entwurf fertig
    [ESP8266.SchDoc, ESP8684H4.SchDoc]
2025-05-18 Struktur angepasst und ESP8266 Entwurf hochgeladen
    [ESP8266.PcbDoc, ESP8266.SchDoc, ESP8684H4.SchDoc, Inv_Pen_PCB.PrjPcb, Modell_ELEK.SLDPRT, PCB1.PcbDoc, PcbLib1.PcbLib, RF_ESP8266.SchLib]
2025-05-20 added Components folder and calculation of DC-Motor
    [Bestellliste.xlsx, Motorberechnung.xlsx]
2025-05-25 added datasheets and Bestellliste
    [Bestellliste.xlsx, ESP8266_Pin_List_0.xls]
2025-05-26 ESP8266 Schaltplan hochgeladen
    [ESP8266.PcbDoc, ESP8266.SchDoc, PcbLib1.PcbLib, RF_ESP8266.SchLib]
2025-05-26 Bestellliste geupdatet
    [Bestellliste.xlsx, pinbelegung.ods]
2025-05-28 stm32 schematic
    [stm32_schematic.SchDoc]
2025-05-29 Daten bereinigt, Zusammenbau erstellt
    [ESP8266.SchDoc, STM32.SchDoc, UART.SchDoc, Zus.SchDoc, Zusammenbau.SchDoc]
2025-05-31 UART Schnittstelle fast fertig
    [PCB_USB_UART.SchDoc, UART_Schnittstelle.PrjPcb]
2025-06-01 added all datasheets for UART Topic
2025-06-01 UART Schnittstelle fertig
    [PCB_USB_UART.SchDoc]
2025-06-02 merged schematics into new project
    [ESP8266_final.SchDoc, PCB1.PcbDoc, PCB_USB_UART.SchDoc, PcbLib1.PcbLib, RF_ESP8266.SchLib, merged_project.PrjPcb, pinbelegung.ods, stm32_schematic.SchDoc]
2025-06-03 Bestellliste bearbeitet
    [Bestellliste_MCI.xlsm, Komponenten_Bestellliste.xlsm]
2025-06-03 Bestelllisten fertiggestellt
    [Bestellliste.xlsx, Bestellliste_MCI.xlsm, Komponenten_Bestellliste.xlsm, Komponenten_aus_BOM_Vergleich.xlsx, PCB_Komponenten_Bestellliste.xlsm, Zukaufteile_Bestellliste.xlsx]
2025-06-03 Flash in Bestelliste hinzugefügt
    [ESP8266.PcbDoc, ESP8266.SchDoc, Komponenten_aus_BOM_Vergleich.xlsx, PCB_Komponenten_Bestellliste.xlsm]
2025-06-03 Bestelliste ESP01 hinzugefügt
    [Akku.SLDPRT, Akku_Aufnahme.SLDPRT, Akkubaugruppe.SLDASM, DC-DC.SLDPRT, ESP8266.SchDoc, ESP8684H4.SchDoc, Gesamtbaugruppe.SLDASM, Motor.SLDPRT]
2025-06-03 updated Bestellliste
    [Komponenten_aus_BOM_Vergleich.xlsx, PCB_Komponenten_Bestellliste.xlsm, Zukaufteile_Bestellliste.xlsx]
2025-06-03 added MCI Logo file
    [LOGO_MCI.dxf]
2025-06-03 neuer Stand PCB
    [ESP8266_final.SchDoc, PCB1.PcbDoc, PCB_USB_UART.SchDoc, PcbLib1.PcbLib, RF_ESP8266.SchLib, merged_project.PrjPcb, stm32_schematic.SchDoc]
2025-06-04 added Bestellliste final
    [PCB_Komponenten_Bestellliste.xlsm, PCB_Komponenten_Bestellliste_ALT.xlsm]
2025-06-05 PCB auf 4 Layer umgebaut
    [ESP8266_final.SchDoc, PCB1.PcbDoc, PCB_USB_UART.SchDoc, PcbLib1.PcbLib, RF_ESP8266.SchLib, merged_project.PrjPcb, stm32_schematic.SchDoc]
2025-06-06 stm32 fertig geroutet
    [ESP8266_final.SchDoc, PCB1.PcbDoc, PCB_USB_UART.SchDoc, RF_ESP8266.SchLib, merged_project.PrjPcb, stm32_schematic.SchDoc]
2025-06-06 minor fix am PCB
    [PCB1.PcbDoc]
2025-06-09 PCB UART part fertig - i kann nimma echt jetzt. Am Dienstag bestellen ma den kas endlich!
    [PCB1.PcbDoc, PCB_USB_UART.SchDoc, stm32_schematic.SchDoc]
2025-06-09 WIFI modul integriert, finale Version PCB
    [Aufprallpuffer.SLDPRT, ESP8266_final.SchDoc, PCB1.PcbDoc, PCB_USB_UART.SchDoc, PcbLib1.PcbLib, Plexiglas.SLDPRT, RF_ESP8266.SchLib, Verbinder.SLDPRT]
2025-06-10 kleines fixes am PCB
    [PCB1.PcbDoc]
2025-06-10 FINAL PCB
2025-06-10 FINAL PCB mit Gerber
    [ESP8266_final.SchDoc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]
2025-06-11 Bestellliste angepasst und Bestell-Mail versendet
    [PCB_Komponenten_Bestellliste.xlsm, Zukaufteile.xlsm]
